jojo082708/fsr_recorder_v7/docs/設計說明.md

# 外穿式布鞋 FSR 雙點足底力量量測平台：AFO v17 設計說明（版次 B，草案，待確認）

## 0. 這版改了什麼（相對於 v16 草案）

| 你的要求 | v17 的做法 |
|---|---|
| 保留小腿件（上面放麵包板，已經列印） | `AFO_leg` 完全沿用 v15 原件，沒有任何修改。腳底件後跟杯的內側介面也保持不變（小腿件套筒和後跟杯之間的間隙約 0.4 mm） |
| 刪除外掛電控盒（E 模組盒、滑軌、托盤） | 已刪除。麵包板和 ESP32 改放在小腿件背面原本的位置，圖上只是示意 |
| 腳底板不要做成腳的形狀，要像 AFO（參考圖 3） | 回到 v15 的 AFO 托盤外形（圓角鞋底輪廓），有立邊、後跟杯和兩側束帶扣環。腳印只用來定感測器位置 |
| 只在大拇趾球和腳跟放滾珠式 FSR | 托盤底板上挖兩個感測匣口袋：S1（第一蹠骨頭）、S2（腳跟）。匣子頂面和底板面（z = 15）齊平 |
| 刪除舊 FSR 構造 | 刪除 v15 的舊 FSR 構造，填平到 z = 15：<br>• x≈100 的橫向貫穿槽，以及它穿過兩側牆的開口（已補牆）<br>• 中央 T 形溝<br>• 兩條長方形凹槽 |

| 只考慮鞋子數據（鞋底長 31 cm、寬 11 cm） | 托盤自 x = 80 往前拉長 ×1.286、加寬 ×1.133（平滑過渡），腳底件變成 346 × 134 × 76。後跟杯（x < 80，小腿件介面）完全不動。鞋頭擋塊、束帶扣環隨托盤一起放大 |

束帶扣環、底部三角格柵都照 v15 保留。

工程圖：`drawings/FSR_AFO_v17_Drawings.pdf`（12 張，A3）。3D 成品檢視：https://claude.ai/artifact/WfMZFsg2Vjy7nbR9LSAPM5（原始碼 `viewer/index.html`，模型由 `cad/export_glb.py` 產生）。

| 圖號 | 內容 |
|---|---|
| FSR-01 | 整體側視圖 |
| FSR-02 | 整體正視圖 |
| FSR-03 | 整體後視圖 |
| FSR-04 | 整體俯視圖 |
| FSR-05 | 腳底件底視圖 |
| FSR-06 | 整體等角圖 |
| FSR-07 | 布鞋 + 平台組合等角圖 |
| FSR-08 | 固定機構爆炸圖 |
| FSR-09 | 雙 FSR 剖面圖 |
| FSR-10 | 電子模組與走線圖 |
| FSR-11 | 整體爆炸圖 + 零件表 |
| FSR-12 | 感測器位置圖 |

座標系沿用 v15：原點在腳底件後緣底面的中線上，+X 朝腳尖、+Y 朝左（左腳時是外側）、+Z 朝上，單位 mm。

---

## 模組化（可拆卸）

- 共用後段 F1A：後跟杯、小腿件介面、S2 感測匣、走線出口、H1 墊塊插腳孔。只印一次。
- 可換前段 F1B：S1 感測匣，依尺寸產生，搭配對應的鞋頭擋塊 T1。
- 接合方式：x = 120 底板搭接 30 mm，6 × M4×12 平頭螺絲由底面鎖入後段熱熔螺母，可重複拆裝。
- 放大範圍：從 x = 140 之後才開始放大，所以後段在所有尺寸都相同。
- 赤腳：插入 H1 腳跟墊塊（12 mm 月牙形，2 支 Ø5 插腳），腳跟位置與穿鞋相同，感測器位置不變。
- 產生任意尺寸：`python3 cad/export_kit.py OUT shoe:長x寬 barefoot:腳長x腳寬`。

## 兩個版本（AFO_VARIANT）

| 項目 | 赤腳版 barefoot | 穿鞋版 shoe |
|---|---|---|
| 依據 | 腳掌 254 × 100（量測） | 鞋底 310 × 110（量測） |
| 腳底件 | 共用後段 + 赤腳前段 → 299 × 122 × 76 | 共用後段 + 穿鞋前段 → 349 × 134 × 76 |
| 腳跟定位 | H1 腳跟墊塊 12 mm | 鞋跟（腳跟→鞋底 12，待確認） |
| S1 / S2 | (197.3, −25) / (45.3, +12) | (197.3, −25) / (45.3, +12) |
| 鞋頭擋塊 | 客製：內緣沿腳趾包絡 + 3 mm，厚 12、高 22，2 支 Ø6 插腳（舊插槽填平） | v15 造型放大 |

## 1. 尺寸參數表（⚠ = 待確認）

| 參數 | 目前值 | 狀態 | 說明 |
|---|---|---|---|
| Shoe_Length | 310 | 已量測 | 鞋尖位置 = 8.3 + 310 + 間隙 2 = 擋塊內面 |
| Shoe_Max_Width | 110 | 已量測 | 托盤前掌內寬 = 110 + 2 × 2。**鞋跟寬必須 ≤ 66**（小腿件套筒內寬）⚠ |
| Sole_Thickness | 25（示意） | ⚠ | 只影響束帶長度和組合圖 |
| **Heel_Offset** | 12 | ⚠ | 腳跟後緣到鞋底後緣的距離。影響 S1、S2 的 X 座標 |
| Platform_Thickness | 15 | 沿用 v15 | 底板面 z = 15，感測匣頂面在這個高度，TPU 傳力柱再高出 0.3 |
| **Sensor1_Position** S1 | (197.3, −25) | ⚠ | X = 8.3 + Heel_Offset + 177，Y = 47 − 72 |
| **Sensor2_Position** S2 | (45.3, +12) | ⚠ | X = 8.3 + Heel_Offset + 25（圖上標 21），Y = 47 − 35 |
| 感測器位置 | 固定 | 設計值 | 不可移動（已取消滑動/偏心調整）；換人時改 Foot_S1 / Foot_S2 參數重印 F1 |
| Ring_Raise | 3 | 設計值 | 感測匣 Ø42 外圈凸環高出底板 3 mm（1.2 倒角）；TPU 傳力面再高 0.3 |
| **ESP32_Size** | 51.5 × 28.3 × 13 | ⚠ | 放在小腿件背面 |
| **Breadboard_Size** | 165 × 55 × 9.5 | ⚠ | 放在小腿件背面（你已經列印的位置） |
| Stop_Gap | 1.0 | 校正後調整 | 決定 FSR 最大受力，約 69 N |
| FSR 402 | Ø18.3、感測區 Ø12.7、厚 0.45 | ⚠ 規格書 | |

所有參數都在 `cad/afo_v17.py` 開頭的 `P`。

---

## 2. 模組說明

### F1 AFO 腳底件 v17（由 v15 修改）

- 外形、後跟杯、束帶扣環、鞋頭擋塊插槽、底部格柵都沿用 v15。
- 兩個感測器正下方 Ø46 範圍改成實心（z 0 → 15），受力可以直接經底板傳到地面。
- 感測器口袋：Ø32 孔（z 3 → 15），加 Ø42.4 × 4 沉台，以及 3 個 M2.5 熱熔螺母孔（Ø3.6）。
- 走線槽：寬 6、z 10 → 13.5，上面蓋 B2 走線蓋板（1.5 t，和底板齊平）。
  - 路線是 S1 → 往後跟 → 與 S2 的線會合 → 後跟杯背面的 Ø5 出線孔（z ≈ 11.75）。
  - 這段會從小腿件套筒底下通過，所以電線不會外露在鞋底摩擦面上。

### L1 小腿件 v15（不改）

- 下緣套筒插進後跟杯內側，用兩側螺絲固定。
- 套筒的內面同時是鞋跟的定位面。
- 背面放麵包板和 ESP32。

### T1 鞋頭擋塊（v15，9 種擇一）

- 依鞋長選 T6 / T9 / T12，依鞋頭高度選 H16 / H22 / H28。

### A4 魔鬼氈（38 mm × 2）

- 穿過托盤兩側的 v15 扣環（x ≈ 140、x ≈ 188），跨過鞋面。
- 小腿部分沿用 v15 的小腿束帶。

### C 鋼珠式 FSR 感測匣 × 2（剖面見 FSR-09）

整個感測匣鬆開 3 支 M2.5 就能從上方取出。

| 件號 | 說明 |
|---|---|
| C0 感測匣殼 | PETG。Ø42 凸環（高出底板 3）+ Ø27 導筒。內有 Ø12 止擋肩和 Ø21.4 頂唇；3 個 M2.5 沉頭孔（固定位置） |
| C1 TPU 導槽 | TPU 95A，外徑 Ø22，頂面 Ø21。有 Ø5.15 導槽孔，下緣是 Ø4.5 防脫唇 |
| C2 鋼珠 | Ø5，SUJ2 |
| C3 FSR 402 | 尾線朝走線槽方向引出 |
| C4 FSR 支撐座 | Ø22 × 1.5，PETG 100% 填充，或用鋁片 |
| C5 保護傳力片 | Ø10 × 0.5，SUS304，用轉印膠黏在 FSR 正中央 |

**鋼珠限位**：
- 側向：被導槽孔限制，只能上下移動。
- 往下：有防脫唇擋住。
- 整個導槽又被頂唇和止擋肩鎖在殼內，所以鋼珠不會脫出。

**受力路徑**：鞋底 → TPU 頂面 → 鋼珠 → 保護片 → FSR 中央 → 支撐座 → 腳底件底板 → 地面。

**過載保護**：
- TPU 被壓下的深度超過 Stop_Gap = 1.0 mm 時，外環會坐上止擋肩，多出來的力繞過 FSR。
- FSR 最大受力 ≈ 68.7 · δ^1.5 ≈ 69 N（以 TPU 95A 概算，必須校正）。

**注意**：腳跟的感測匣在小腿件套筒內側（嵌板外緣 y = 33.0，套筒內面 y = 33.2）。

### E 電子（小腿件背面，零件不改）

- 接線：每顆 FSR 串一顆 10 kΩ 接到 3.3 V，分壓點接 ESP32 ADC1（例如 GPIO34 / GPIO35）。
- FSR 線經 2 × JST-XH 2P 接到麵包板。
- 電源方式待確認（行動電源或 18650 模組）。

---

## 3. 零件尺寸表

| 件號 | 名稱 | L × W × H | 數量 | 材料 / 製程 |
|---|---|---|---|---|
| F1A | 腳底件後段 | 139 × 125 × 76 | 1 | PETG 列印 |
| F1B | 腳底件前段 | 237 × 134 × 39 | 1 | PETG 列印 |
| L1 | AFO 小腿件 v15 | 69 × 98 × 239 | 1 | 已列印，不改 |
| T1 | 鞋頭擋塊（v15 造型放大） | 55 × 106 × 30 | 1 | PETG |
| B2 | 走線蓋板 | 172 × 36 × 1.5 | 1 | PETG |
| C0 | 感測匣殼（凸環） | Ø42 × 14.8 | 2 | PETG 100% |
| C1 | TPU 導槽 | Ø22 × 11.8 | 2 | TPU 95A |
| C2 | 鋼珠 | Ø5 | 2（+ 備品 4） | SUJ2 |
| C3 | FSR 402 | Ø18.3 × 0.45 | 2（+ 備品 2） | Interlink |
| C4 | FSR 支撐座 | Ø22 × 1.5 | 2 | PETG / 鋁 |
| C5 | 保護傳力片 | Ø10 × 0.5 | 2 | SUS304 |

## 4. BOM

| 項目 | 規格 | 數量 |
|---|---|---|
| FSR 402 | Interlink | 2 + 2 備品 |
| 鋼珠 | Ø5，G10 | 2 + 4 備品 |
| 保護片 | Ø10 × 0.5 SUS304 | 2 + 2 備品 |
| 轉印膠 | 3M 467MP | 少量 |
| ESP32 DevKit / 長條麵包板 | （⚠ 型號待確認） | 各 1 |
| 電阻 | 10 kΩ 1% | 2 |
| JST-XH 2P 線組 | AWG26–28 矽膠線，約 40 cm | 2 |
| 熱熔螺母 M2.5 | Ø3.6 × 4 | 6 |
| M2.5 × 6 沉頭螺絲 | | 6 |
| 魔鬼氈 | 38 mm，公母各 1 m | 2 條 |
| 螺旋套管 + 束線扣 | | 1 組 |
| 止滑橡膠片（底面）/ 止滑矽膠片（底板面，感測匣處開 Ø22 孔） | 2 mm / 1 mm | 各約 300 × 120 |
| 耗材 | PETG 約 520 g；TPU 95A 約 10 g | |

## 5. 組裝流程

1. **熱熔螺母**：在 F1 兩個口袋的沉台壓入 3 × M2.5 熱熔螺母。
2. **感測匣**（每組）：
   1. 把保護片黏在 FSR 正中央。
   2. FSR 放上支撐座，尾線對準殼體開口。
   3. 鋼珠壓進 TPU 導槽，壓過防脫唇。
   4. 導槽從上方壓入殼體，通過頂唇。
   5. 支撐座卡進殼體底部。
3. **放入感測匣**：放進口袋，選好偏心角度，鎖 3 × M2.5。FSR 尾線接上延長線，放進走線槽。
4. **走線**：延長線從後跟出線孔拉出，蓋上 B2 蓋板（用 2 點膠或過盈卡入）。
5. **小腿件**：裝回 L1（v15 原本的螺絲）。電線沿後跟杯背面往上，套上螺旋套管，用束線扣固定，接到麵包板。
6. **穿鞋**：選好鞋頭擋塊並插上，放入布鞋，扣上魔鬼氈和小腿束帶。

## 6. 測試流程

1. 零點檢查。
2. 單點靜態加載：0 到 40 kg 分階，加載、卸載各 3 次。
3. 隔著鞋底校正。
4. 全身體重靜態測試：雙腳站、單腳站、前傾、後傾。
5. 慢走約 100 步，確認重現性，並檢查潛變和螺絲鬆動。
6. 最後才接到外骨骼做步態量測。

（詳細步驟同 v16 版說明，見 git 歷史。）

## 7. 3D 列印建議

| 零件 | 材料 | 層高 | 外殼 / 填充 | 方向 |
|---|---|---|---|---|
| F1 腳底件 | PETG | 0.2 | 4 牆，30% gyroid | 底面朝下（同 v15） |
| C0 感測匣殼 | PETG | 0.12 | 100% | 嵌板朝下 |
| C1 TPU 導槽 | TPU 95A | 0.12 | 100%，約 20 mm/s | 頂面朝下 |
| B2 蓋板 / C4 支撐座 | PETG | 0.1 | 100% | 平放 |

- 腳底件分兩件列印（印表機 300 × 300 × 350）：F1A 後段 139 × 125 × 76、F1B 前段 237 × 134 × 39；x = 120 底板搭接 30 mm，6 × M4×12 平頭螺絲由底面鎖入後段 M4 熱熔螺母（見 FSR-15）。
- Ø22.4 / Ø22、Ø42.4 / Ø42 這些配合尺寸，建議先印公差試片確認。

## 8. 待你確認

1. 布鞋實測：鞋長、鞋寬、**鞋跟寬（必須 ≤ 66）**、Heel_Offset。
2. S2 距腳跟是 21 還是 25 mm。
3. 麵包板和 ESP32 在小腿件背面的實際位置與尺寸，以及電源方式。

輸出檔：`python3 cad/afo_v17.py --export out/`（STL / 3MF / STEP）、`python3 cad/export_glb.py out/AFO_v17_assembly.glb`；text-to-cad：`python textcad/afo_v17.py`。執行 `python3 cad/afo_v17.py --export out/`，會輸出所有 STL 和 `AFO_v17_foot_and_sensors.step`（faceted，與 v15 相同格式）。小腿件請直接沿用 v15 原檔。
