jojo082708/fsr_recorder_v7/drawings/16_兩版本比較_赤腳版_vs_穿鞋版.png

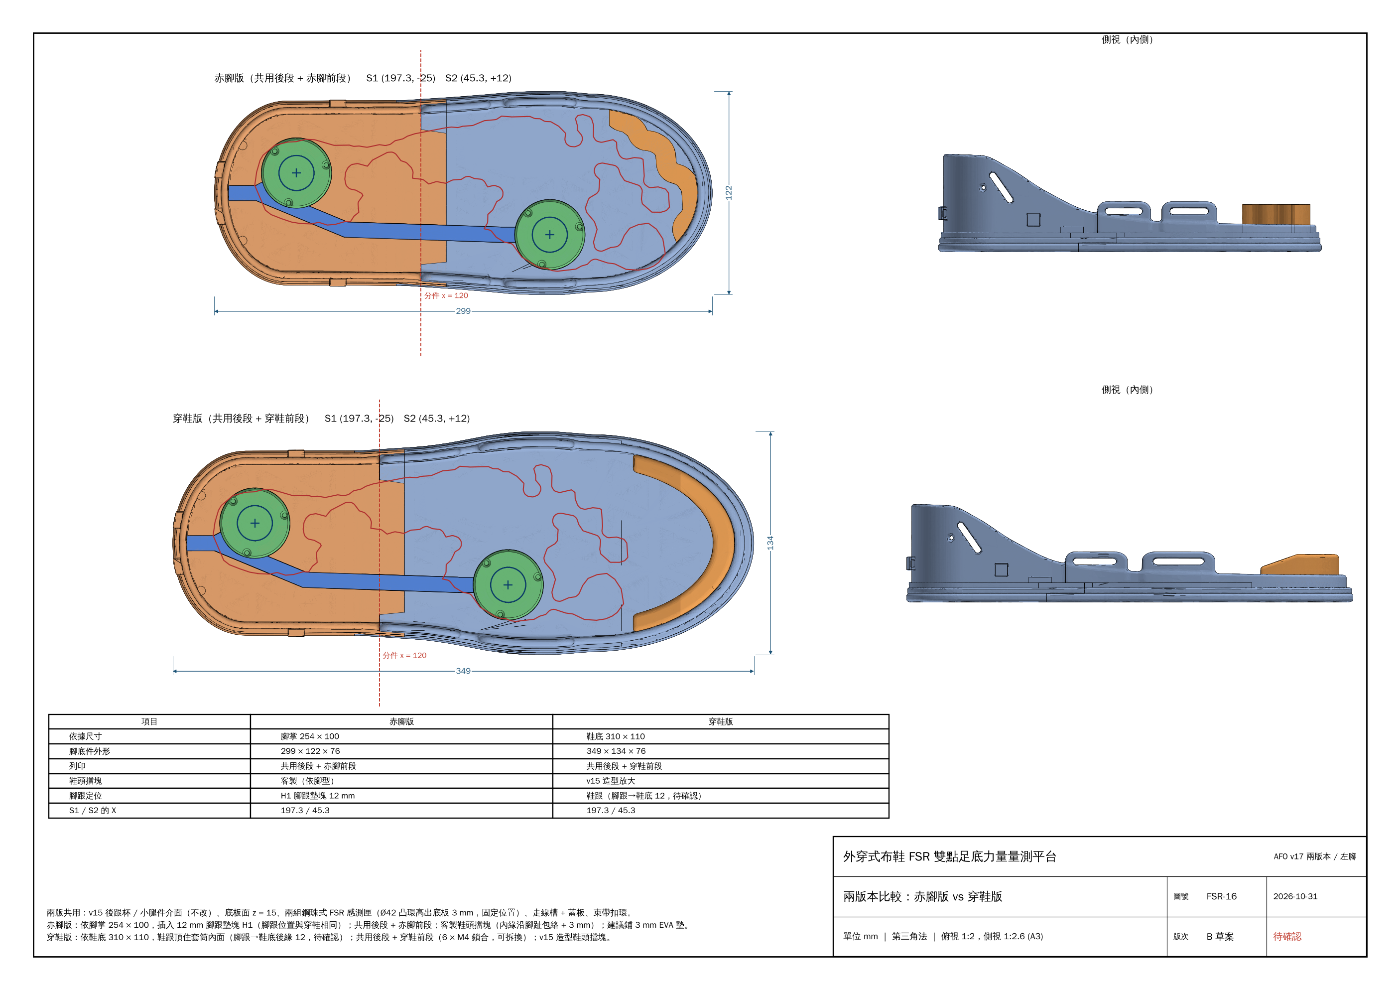
drawings/16_兩版本比較_赤腳版_vs_穿鞋版.png
