jojo082708/fsr_recorder_v7/drawings/17_模組化套件_共用後段_可換前段.png

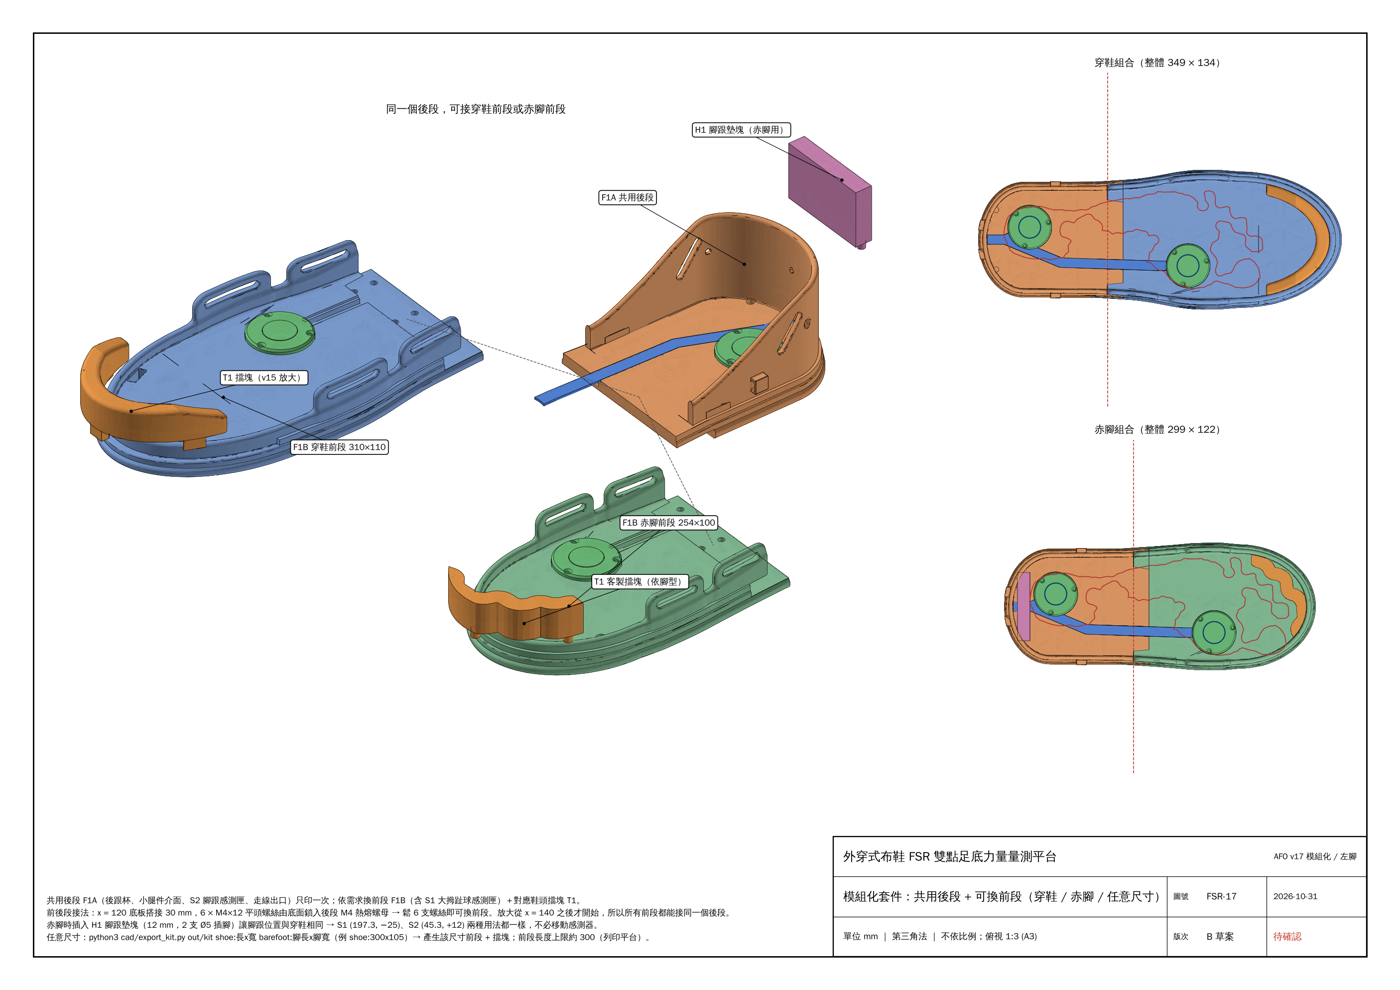
drawings/17_模組化套件_共用後段_可換前段.png
