jojo082708/fsr_recorder_v7/drawings/barefoot/01_側視圖.png

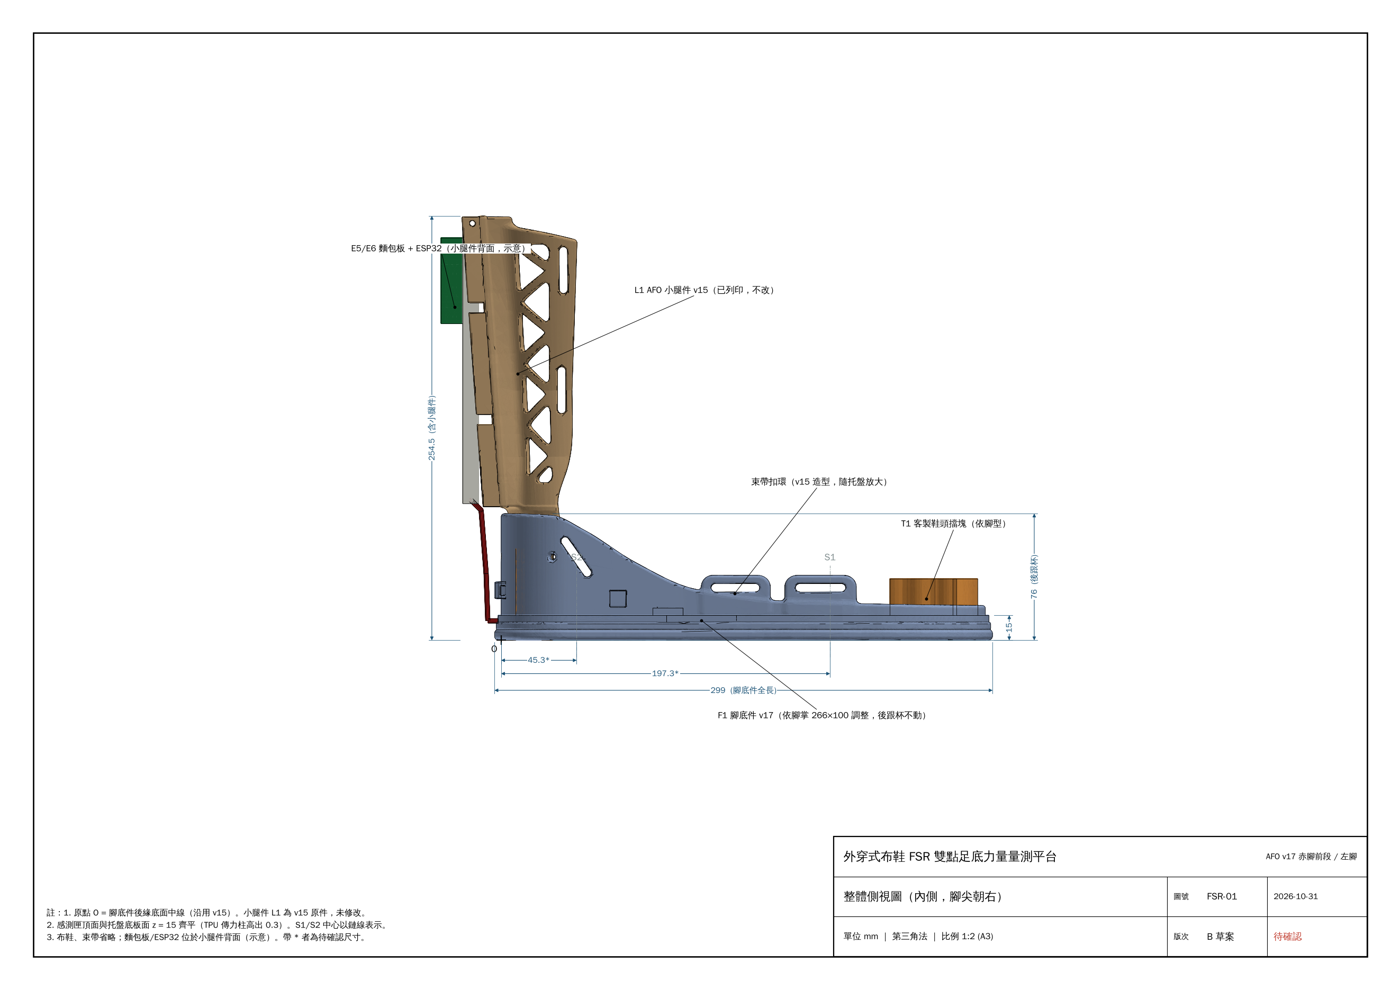
drawings/barefoot/01_側視圖.png
