jojo082708/fsr_recorder_v7/drawings/barefoot/02_正視圖.png

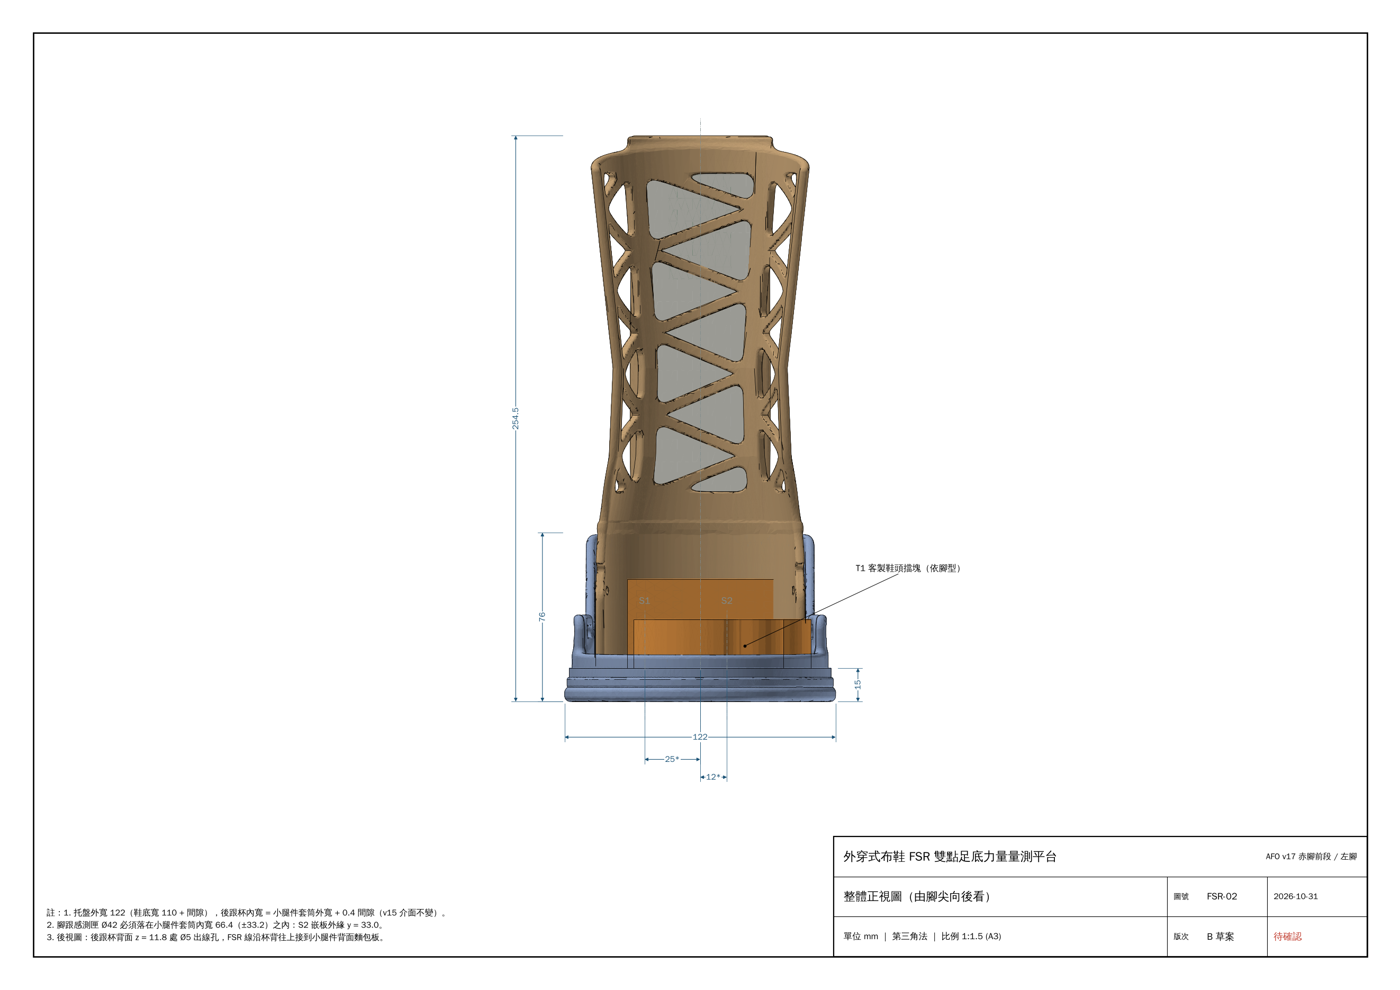
drawings/barefoot/02_正視圖.png
