jojo082708/fsr_recorder_v7/drawings/barefoot/04_俯視圖.png

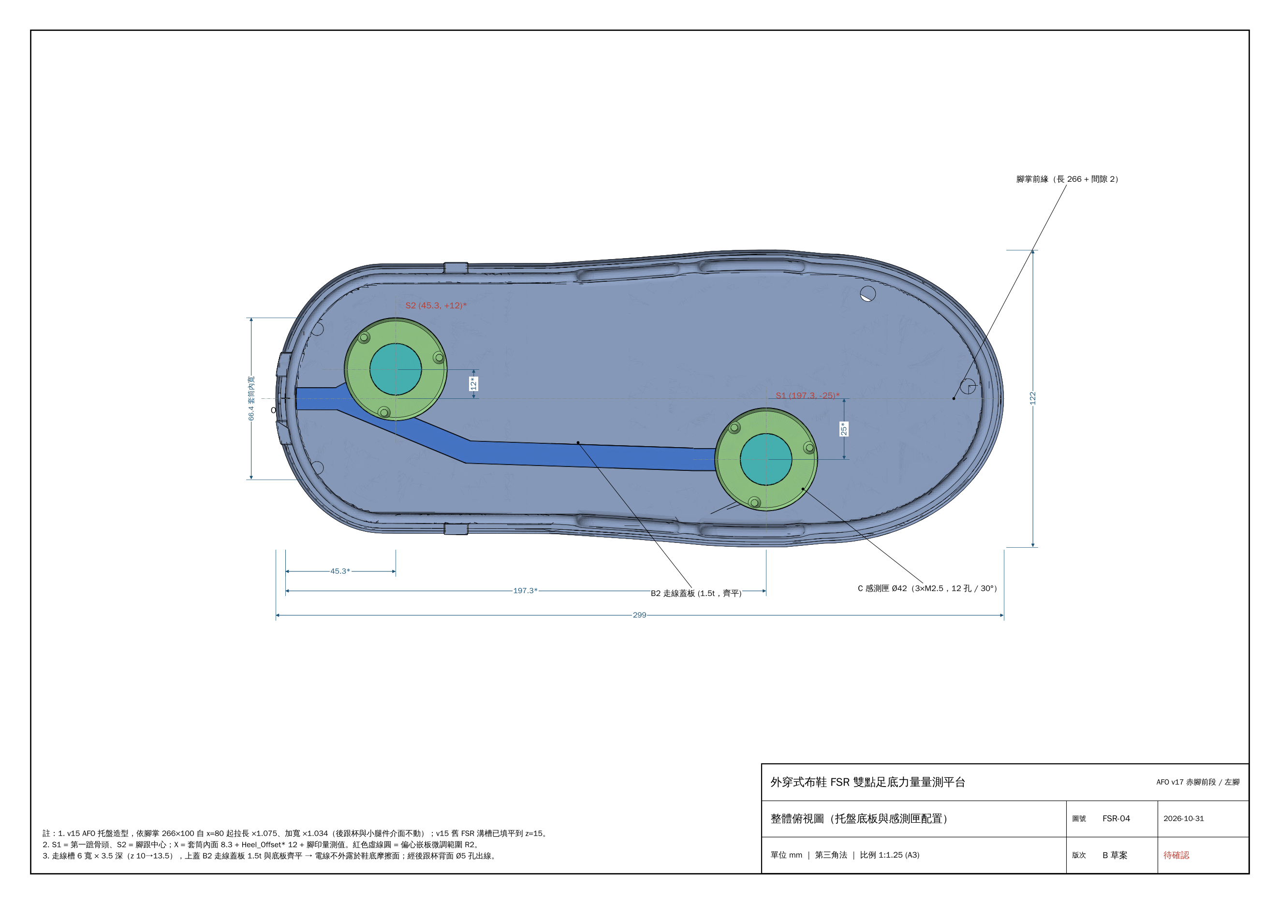
drawings/barefoot/04_俯視圖.png
