jojo082708/fsr_recorder_v7/drawings/barefoot/05_底視圖.png

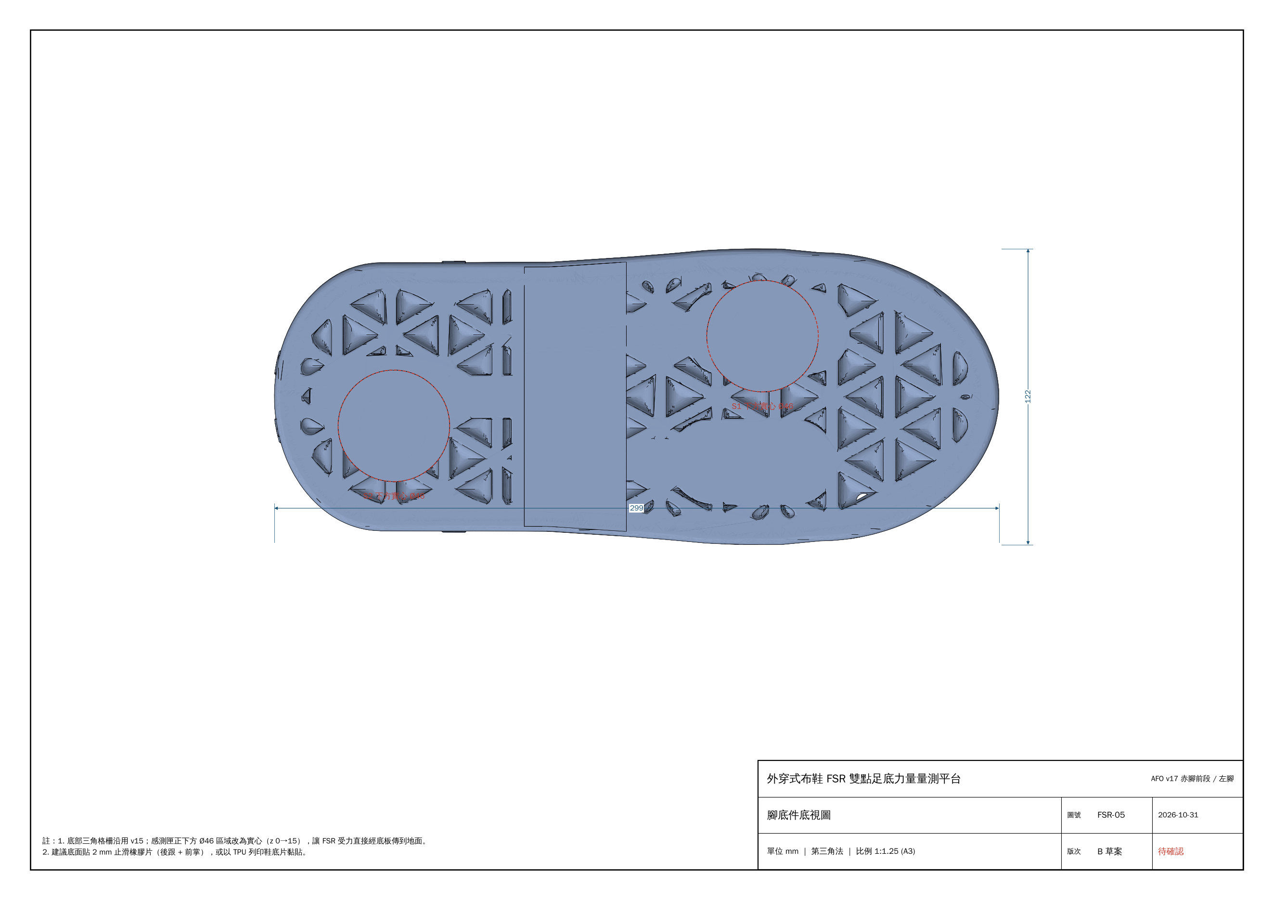
drawings/barefoot/05_底視圖.png
