jojo082708/fsr_recorder_v7/drawings/barefoot/06_等角圖.png

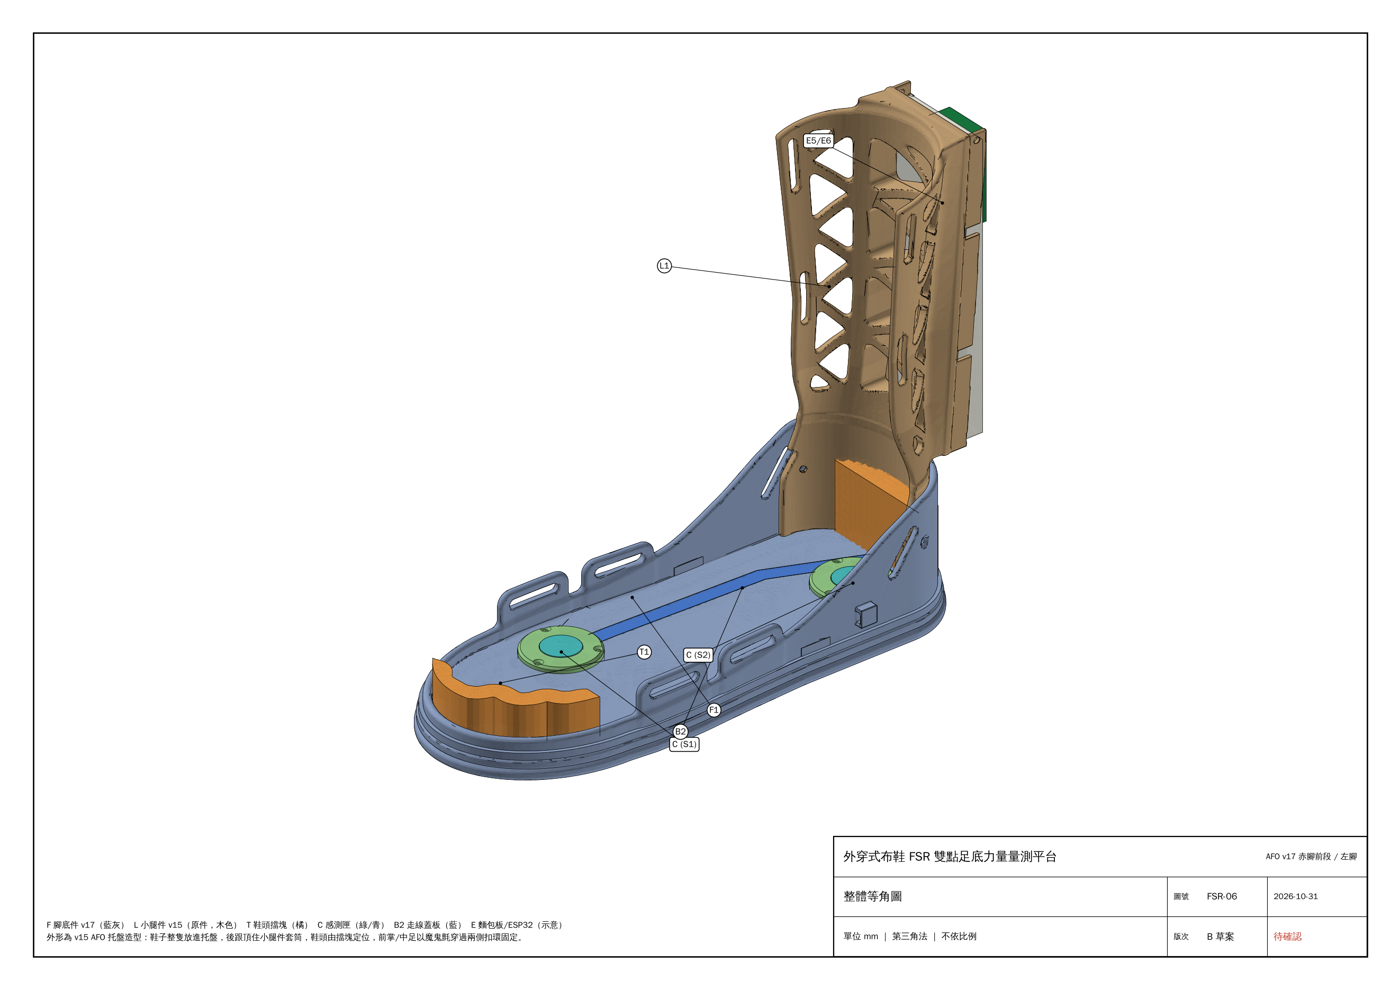
drawings/barefoot/06_等角圖.png
