jojo082708/fsr_recorder_v7/drawings/barefoot/07_布鞋平台組合等角圖.png

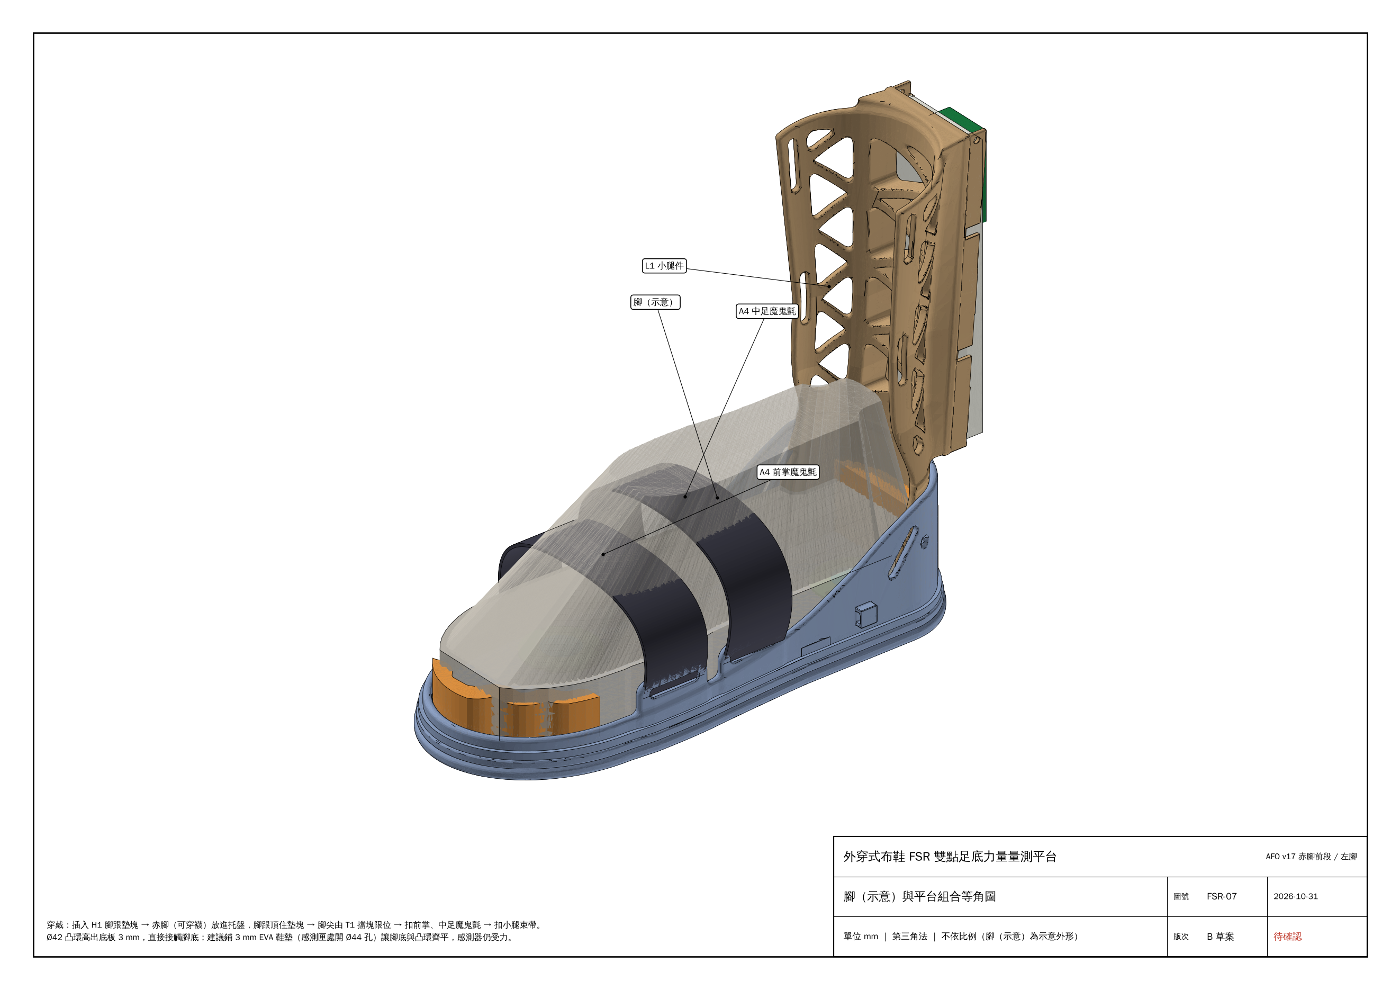
drawings/barefoot/07_布鞋平台組合等角圖.png
