jojo082708/fsr_recorder_v7/drawings/barefoot/08_固定機構爆炸圖.png

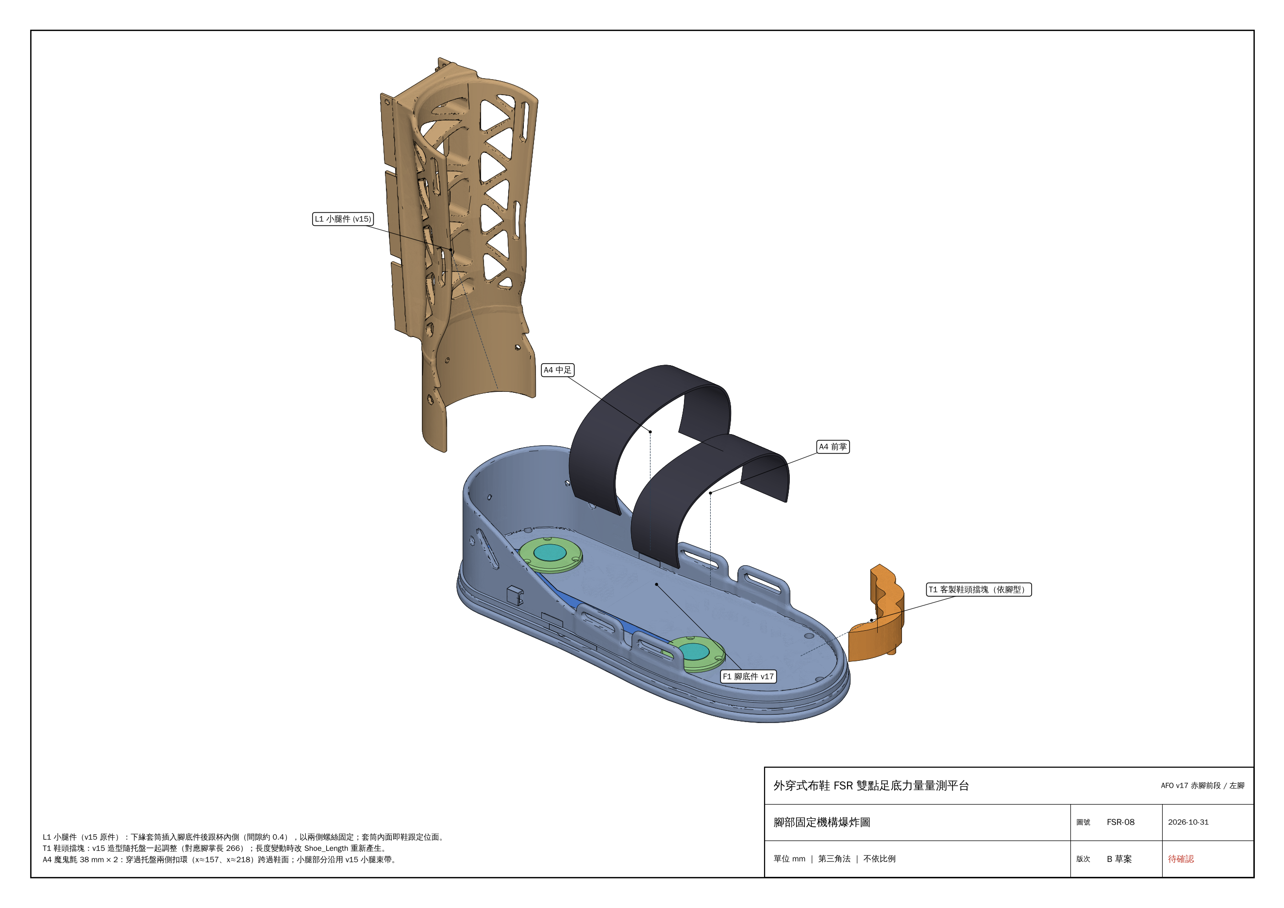
drawings/barefoot/08_固定機構爆炸圖.png
