jojo082708/fsr_recorder_v7/drawings/barefoot/09_雙FSR剖面圖.png

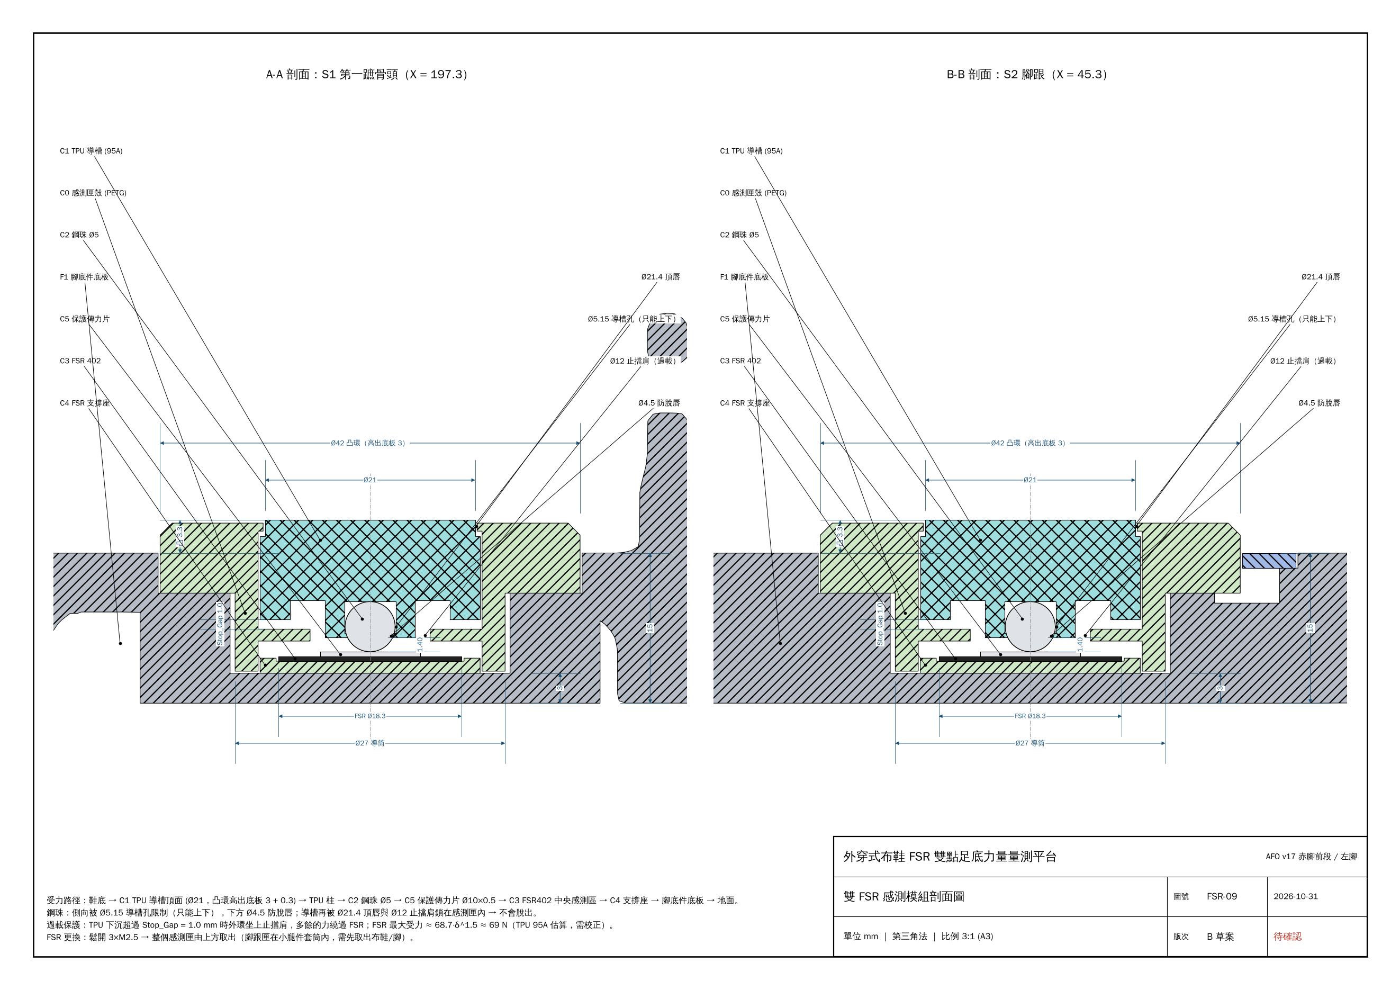
drawings/barefoot/09_雙FSR剖面圖.png
