jojo082708/fsr_recorder_v7/drawings/barefoot/11_整體爆炸組裝圖.png

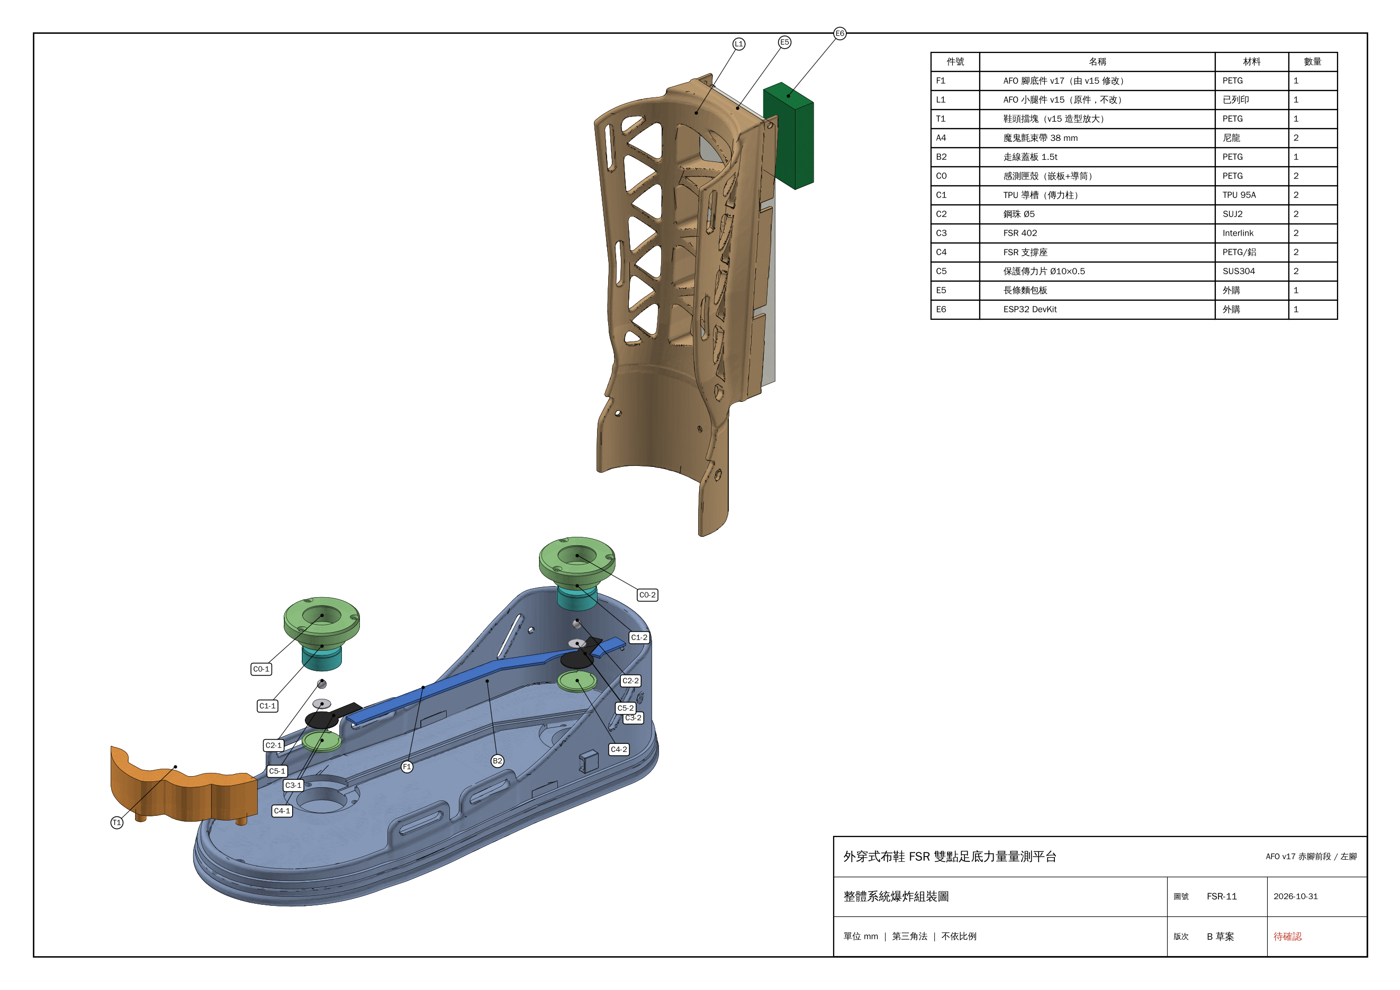
drawings/barefoot/11_整體爆炸組裝圖.png
