jojo082708/fsr_recorder_v7/drawings/barefoot/12_感測器安裝位置圖.png

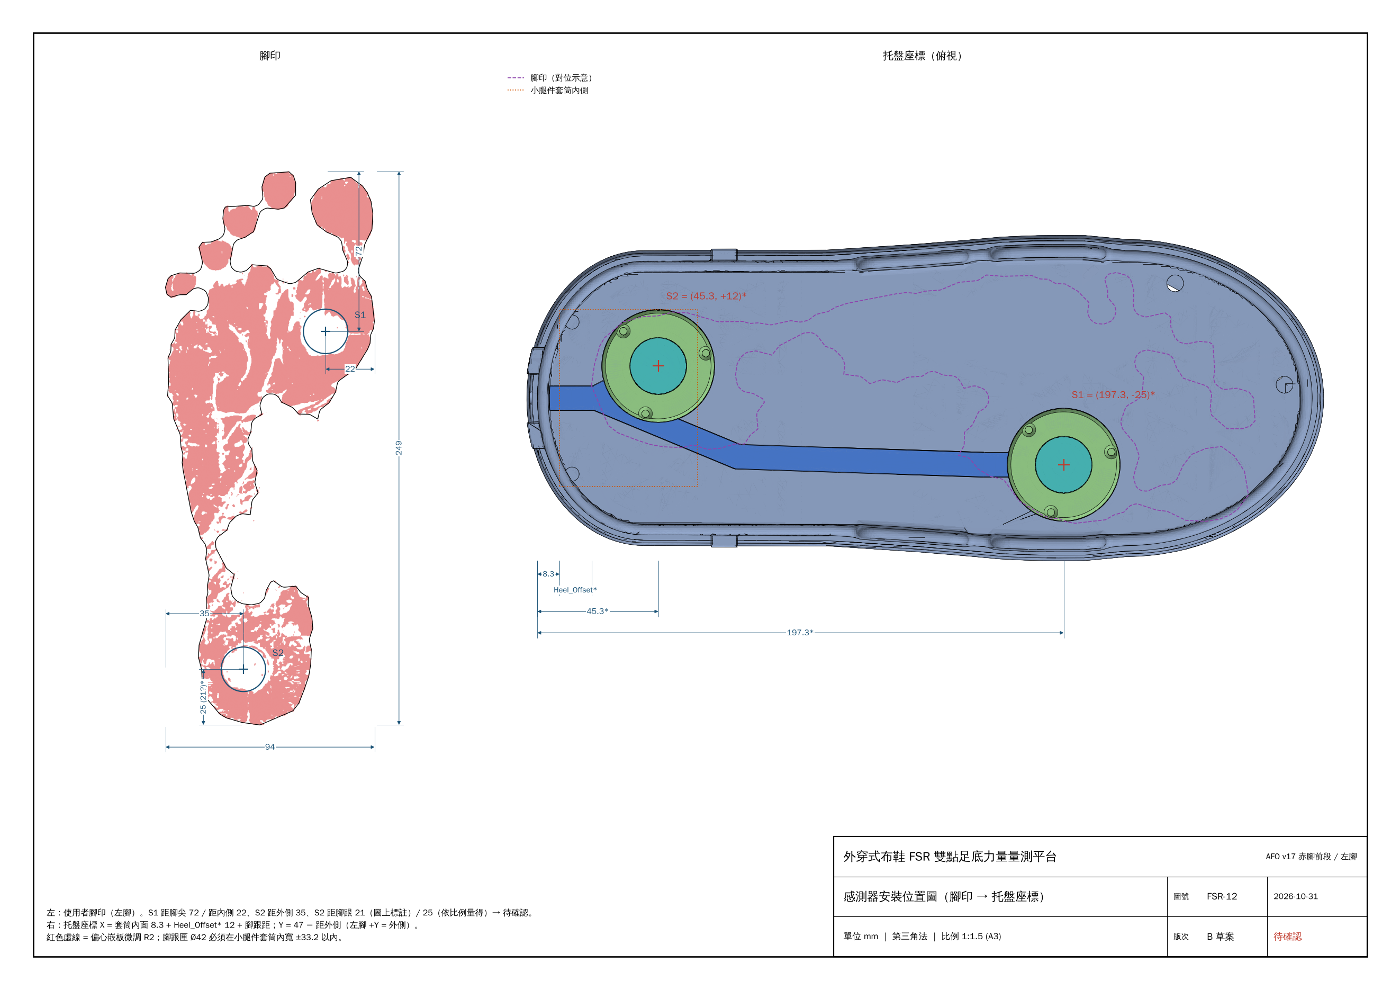
drawings/barefoot/12_感測器安裝位置圖.png
