jojo082708/fsr_recorder_v7/drawings/barefoot/13_腳印鞋型重合俯視圖.png

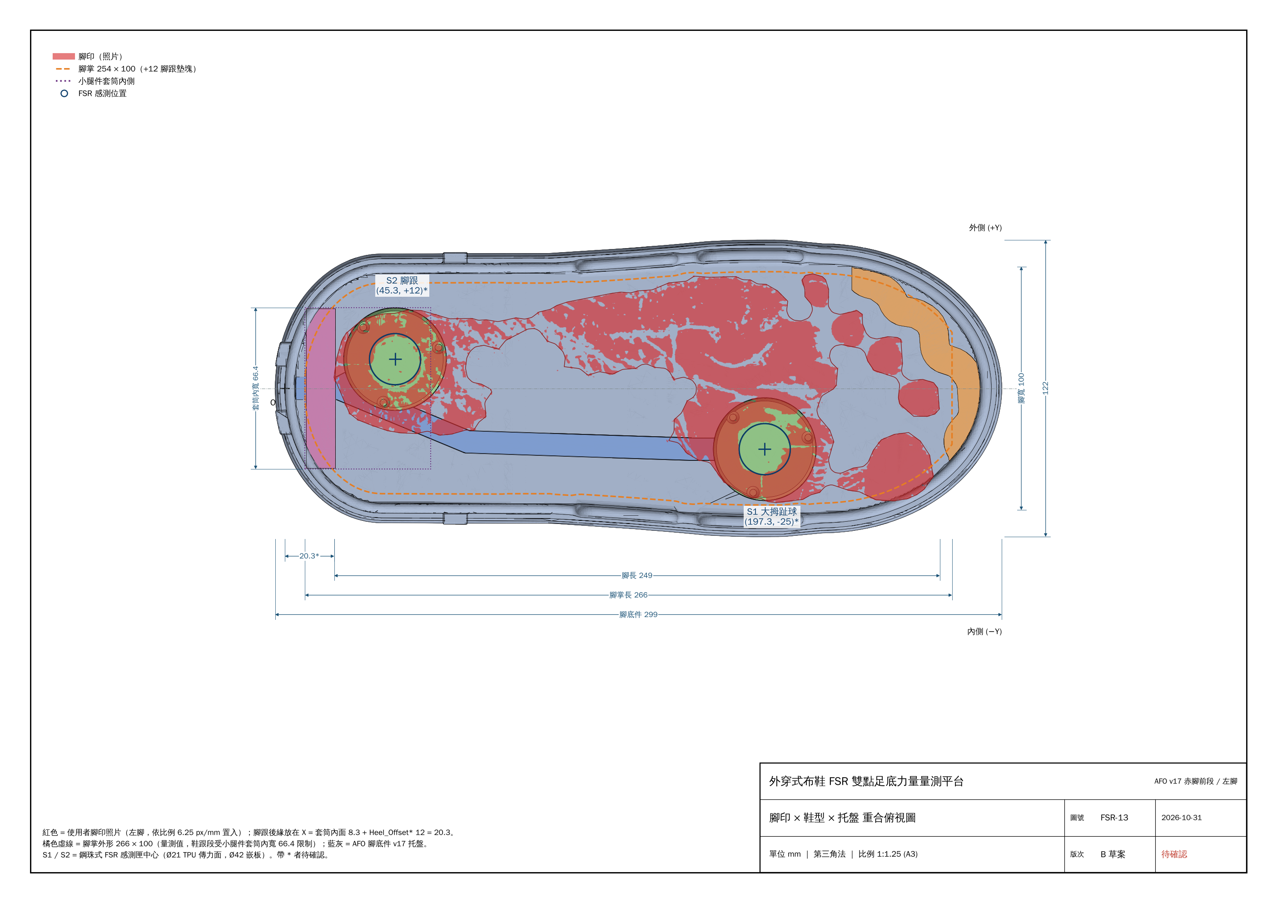
drawings/barefoot/13_腳印鞋型重合俯視圖.png
