jojo082708/fsr_recorder_v7/drawings/barefoot/14_修改前後對照.png

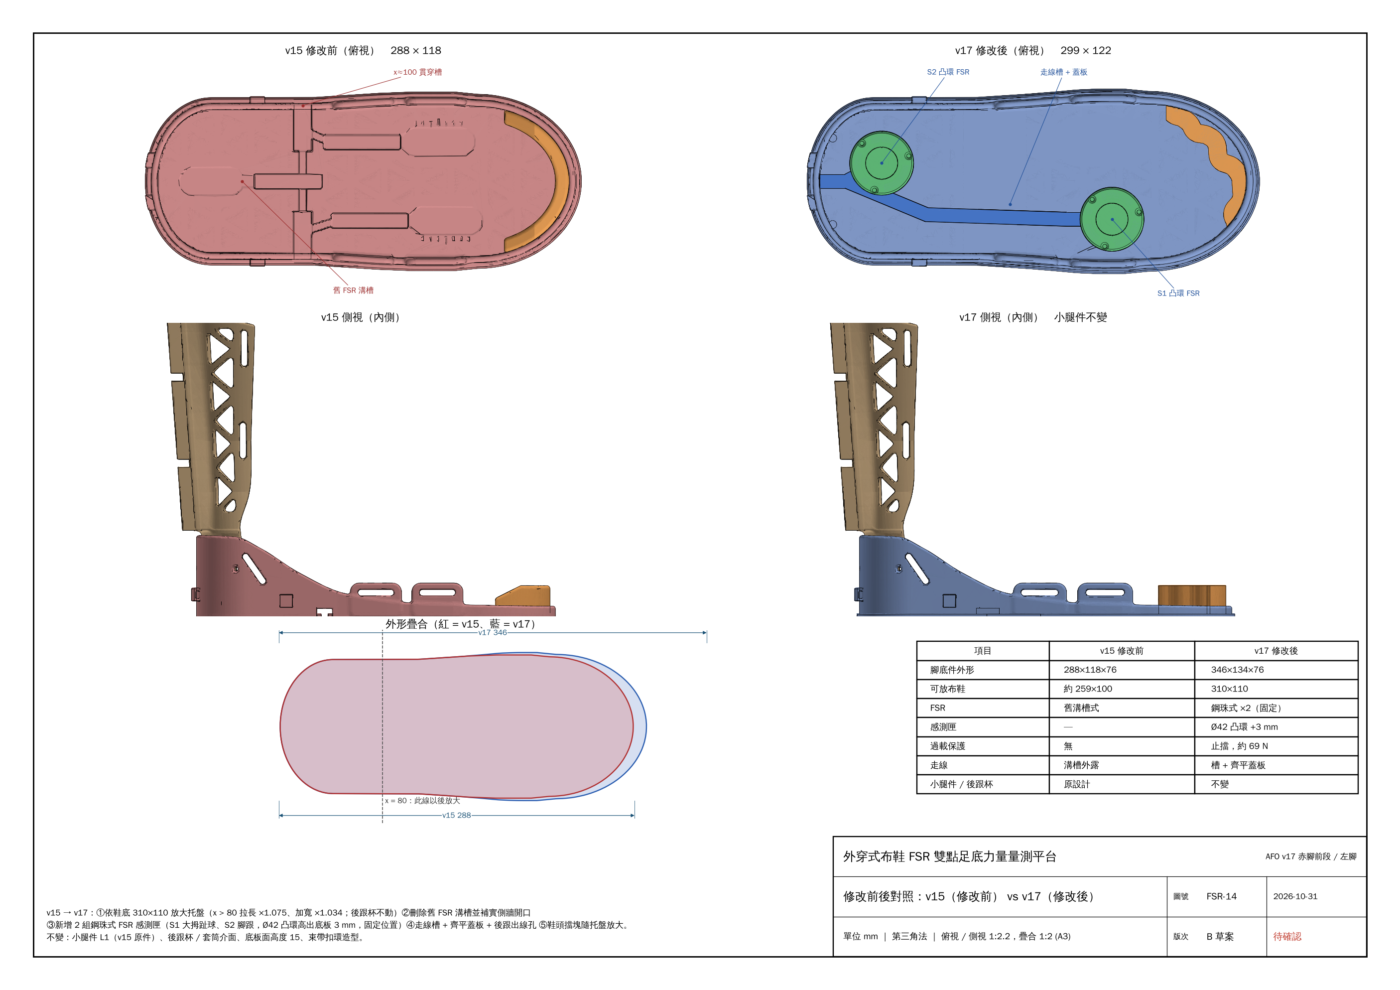
drawings/barefoot/14_修改前後對照.png
