jojo082708/fsr_recorder_v7/drawings/barefoot/15_分件與螺絲接合.png

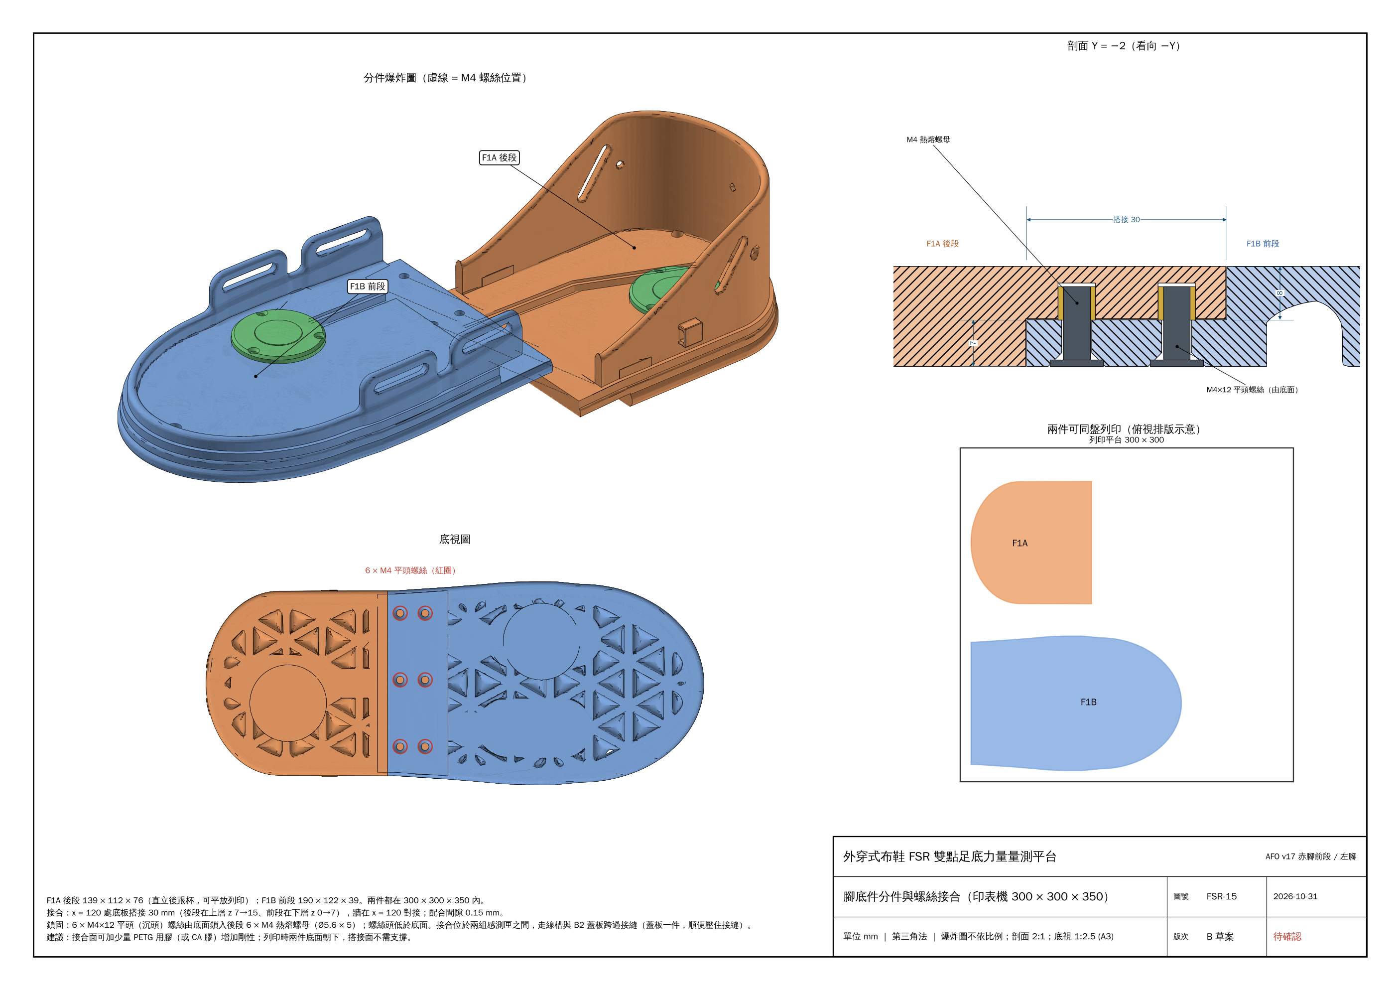
drawings/barefoot/15_分件與螺絲接合.png
