jojo082708/fsr_recorder_v7/drawings/shoe/04_俯視圖.png

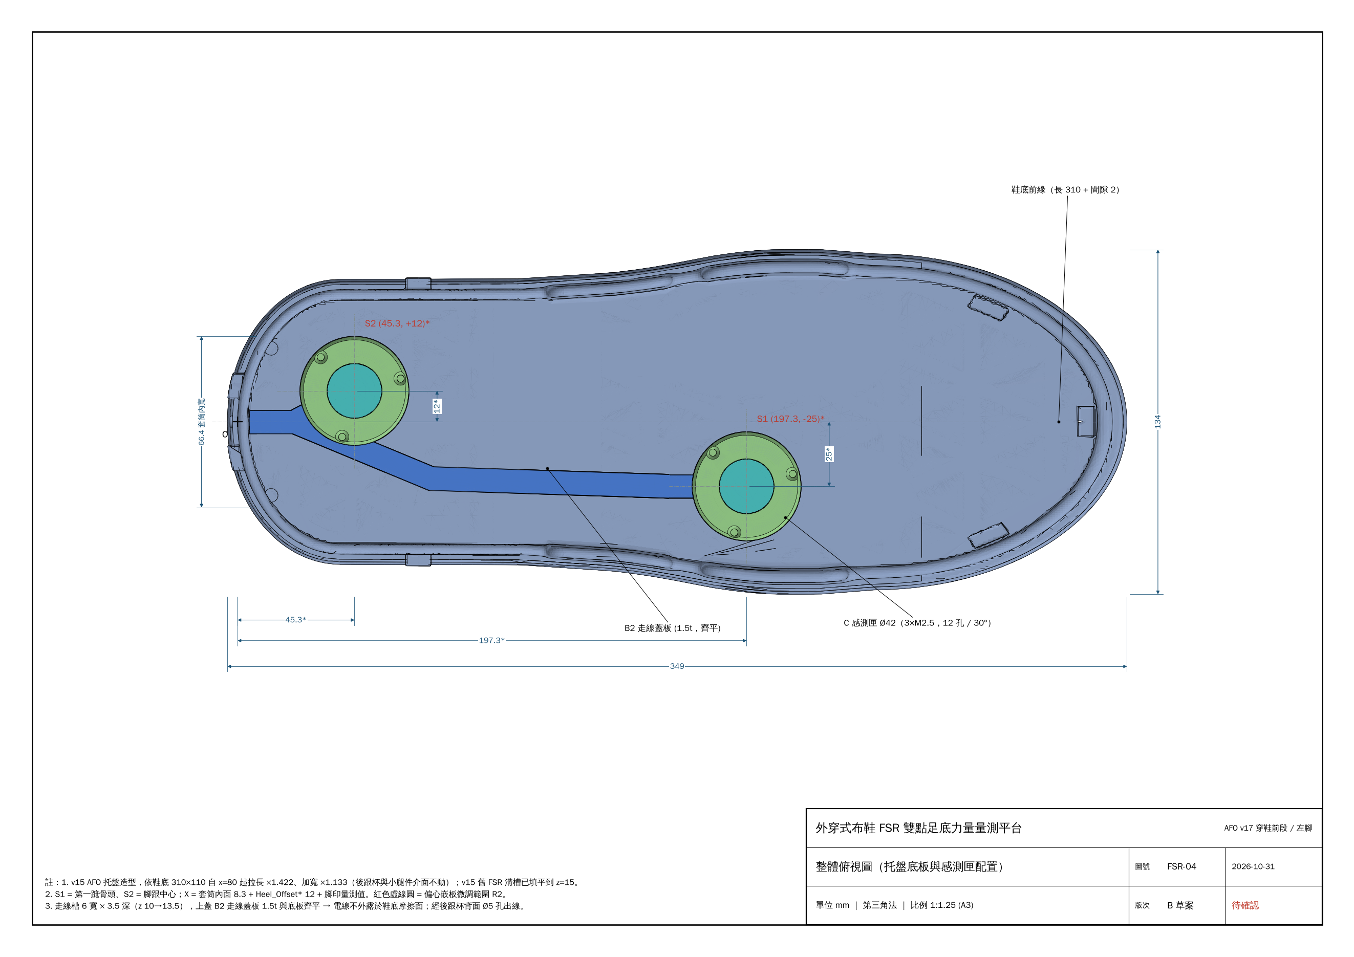
drawings/shoe/04_俯視圖.png
