jojo082708/fsr_recorder_v7/drawings/shoe/05_底視圖.png

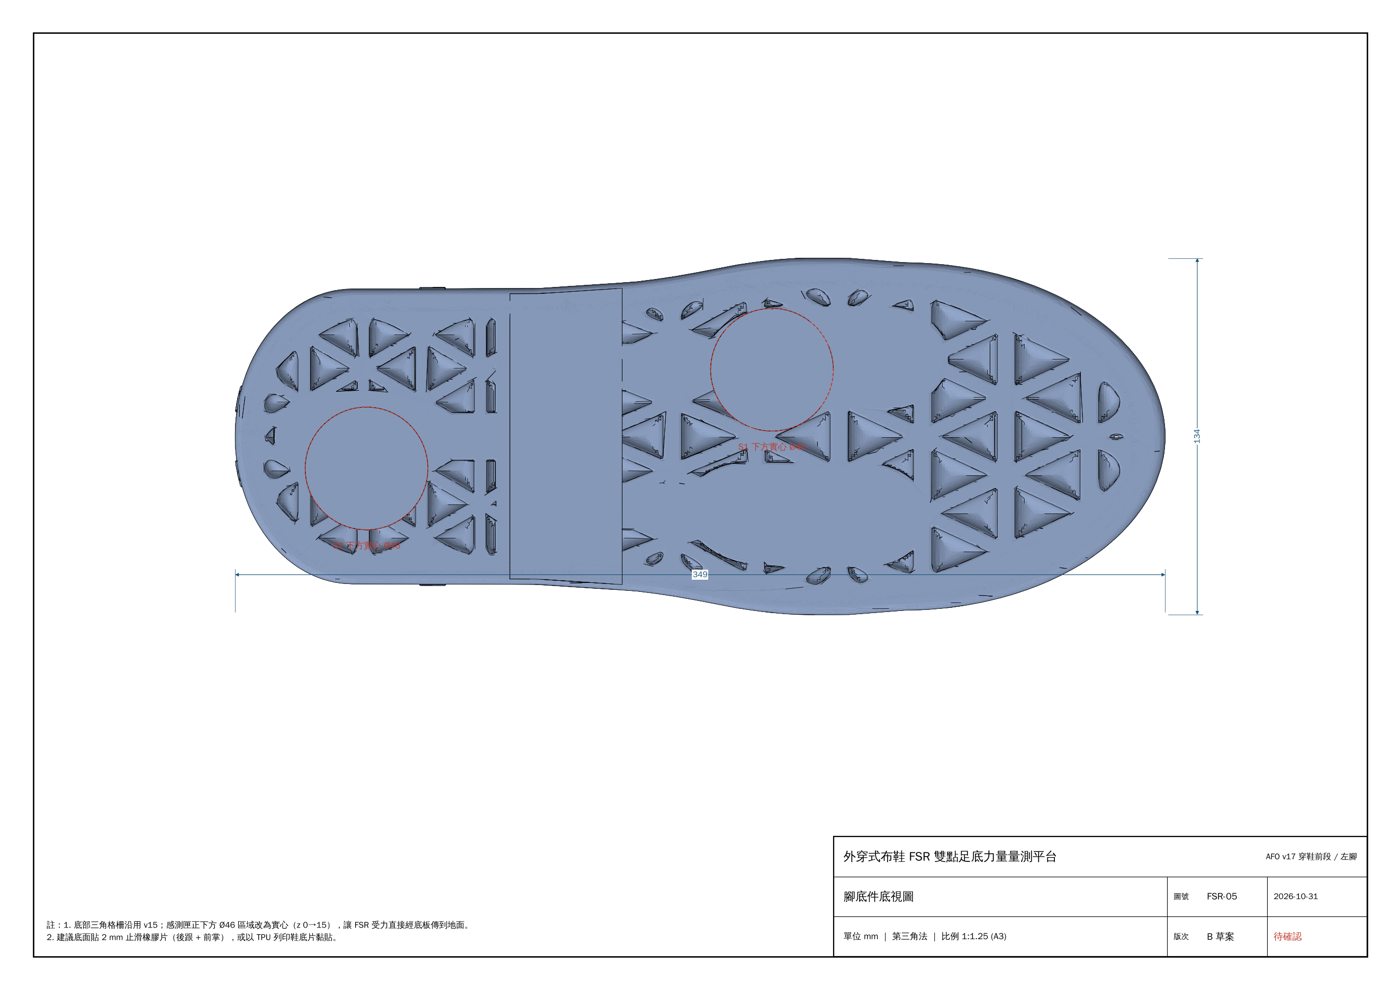
drawings/shoe/05_底視圖.png
