jojo082708/fsr_recorder_v7/drawings/shoe/10_電子模組與走線圖.png

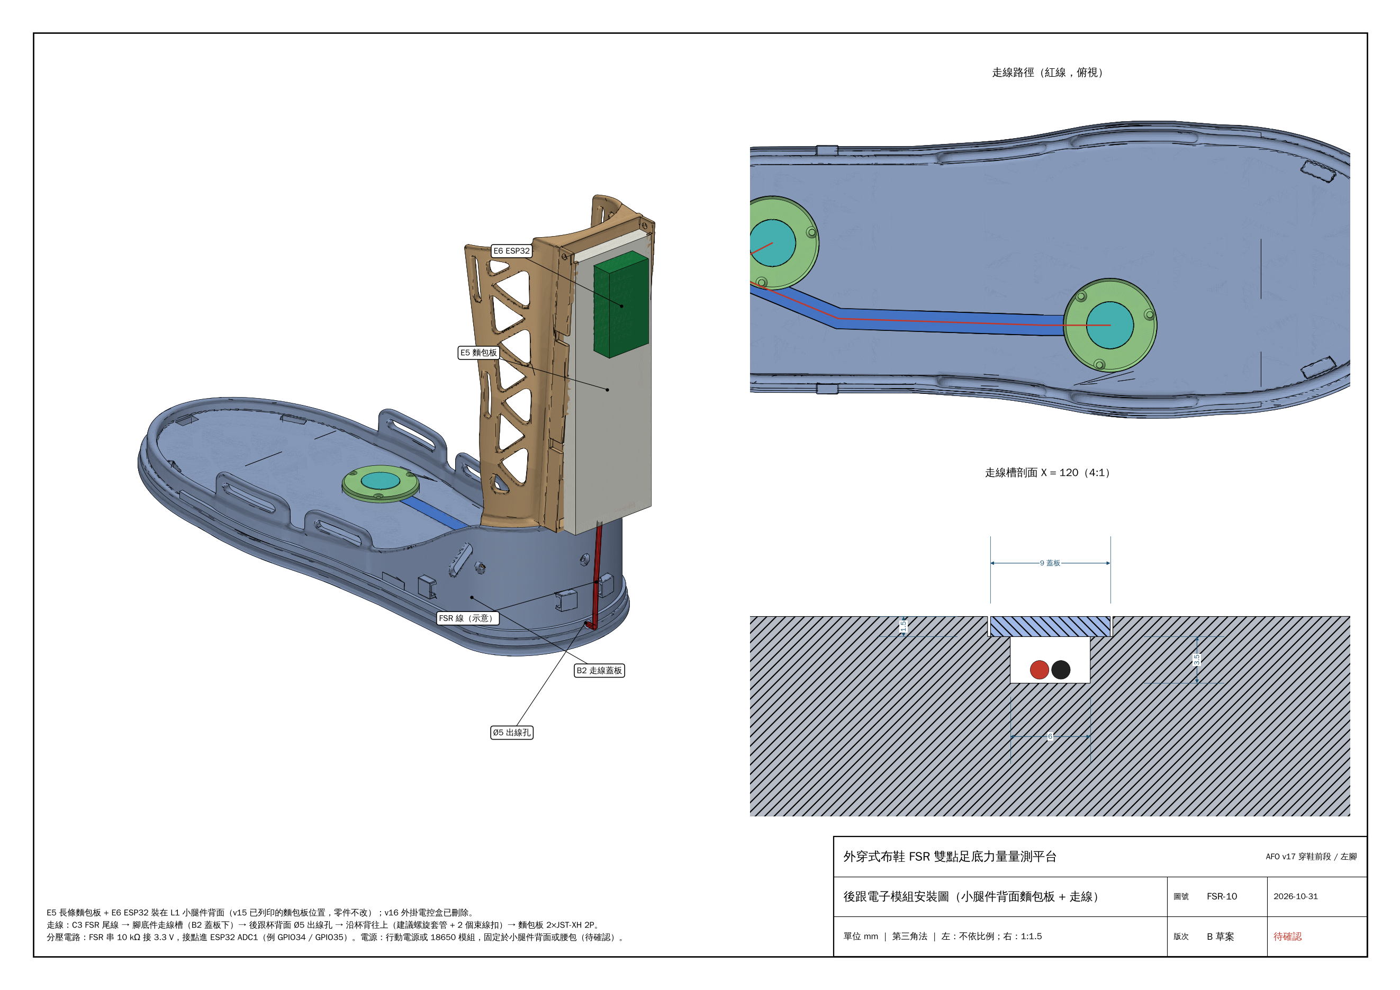
drawings/shoe/10_電子模組與走線圖.png
