jojo082708/fsr_recorder_v7/drawings/shoe/11_整體爆炸組裝圖.png

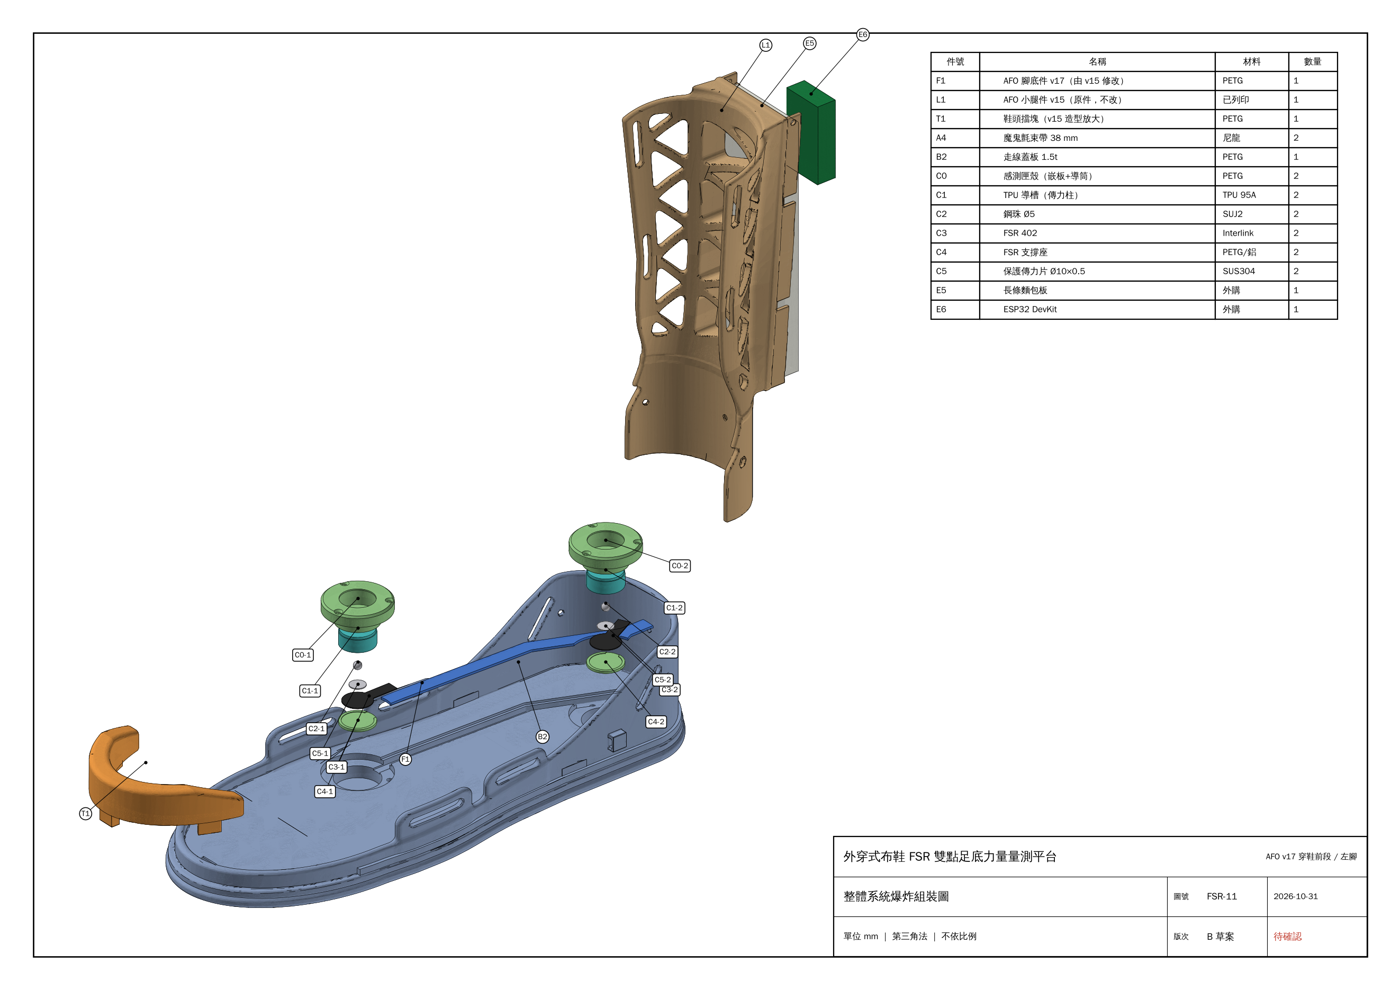
drawings/shoe/11_整體爆炸組裝圖.png
