jojo082708/fsr_recorder_v7/drawings/shoe/13_腳印鞋型重合俯視圖.png

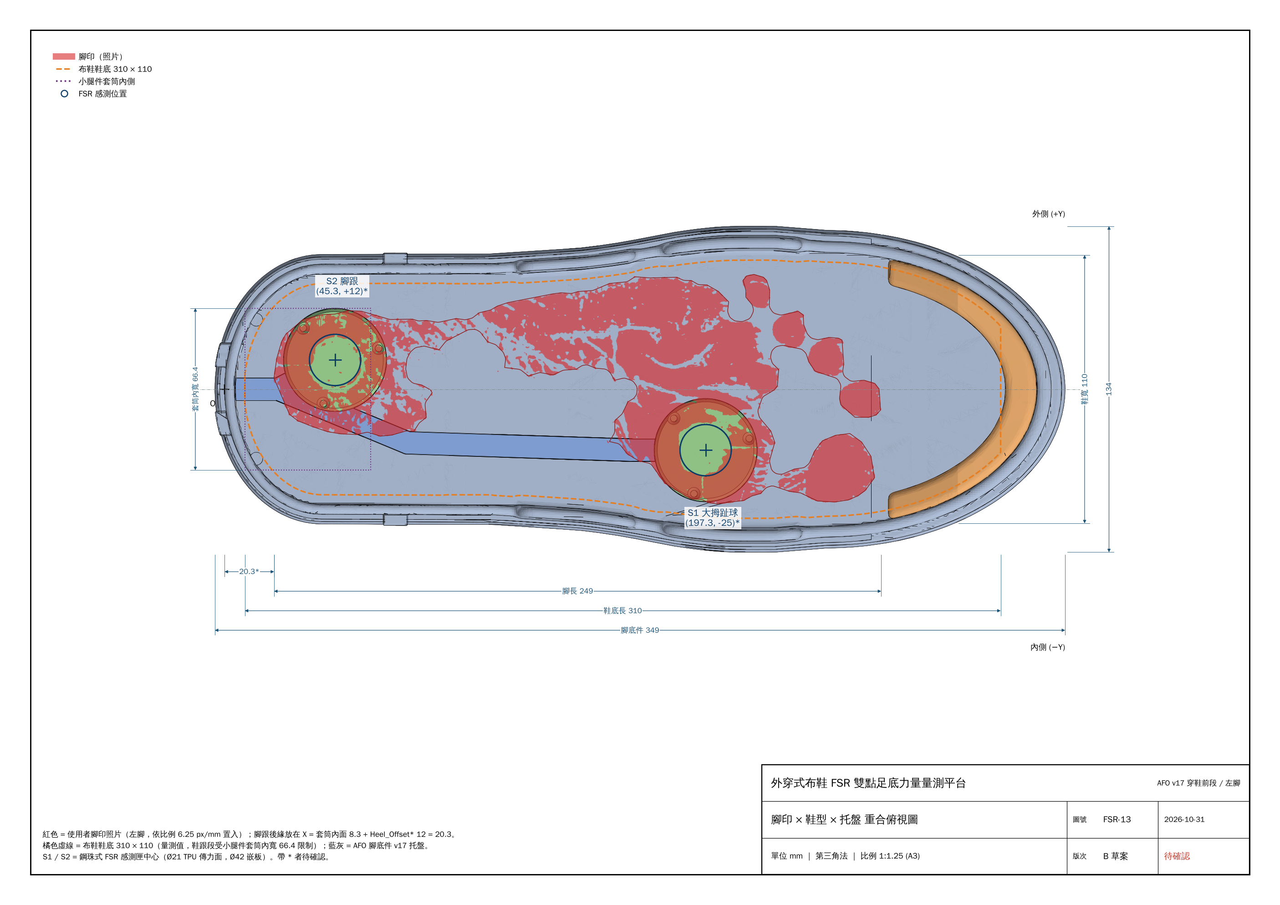
drawings/shoe/13_腳印鞋型重合俯視圖.png
