jojo082708/fsr_recorder_v7/drawings/textcad/overlay_top.png

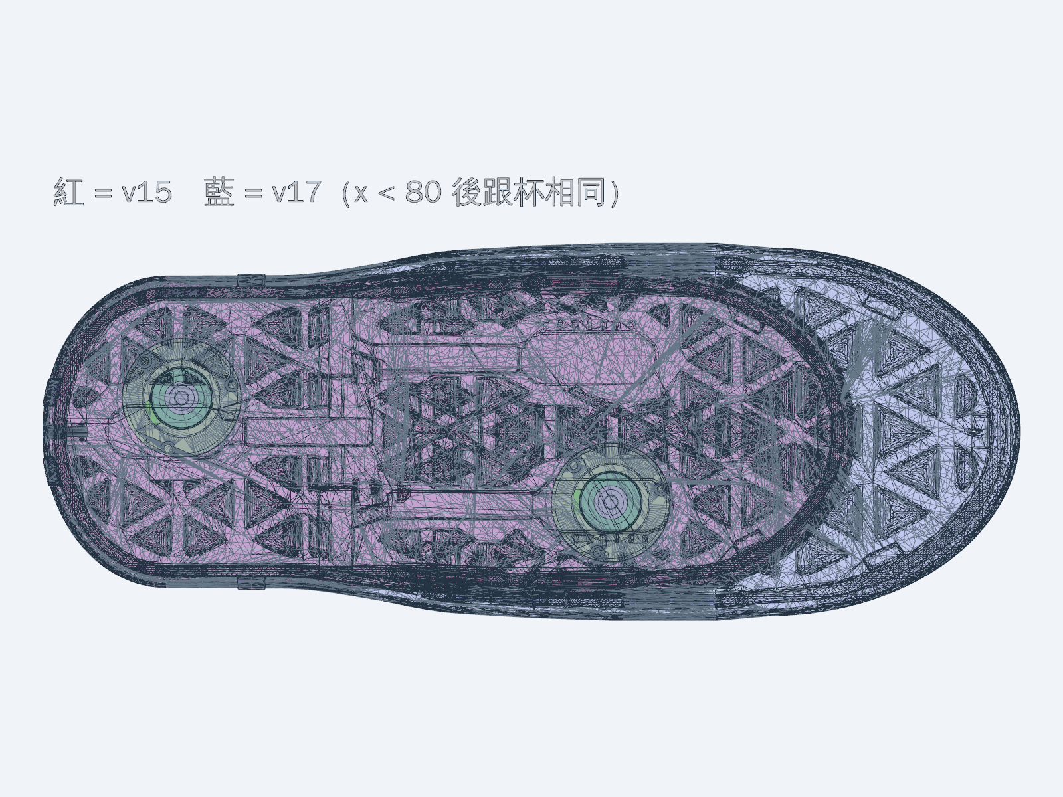
drawings/textcad/overlay_top.png
