jojo082708/fsr_recorder_v7/drawings/textcad/v15_vs_v17_top.png

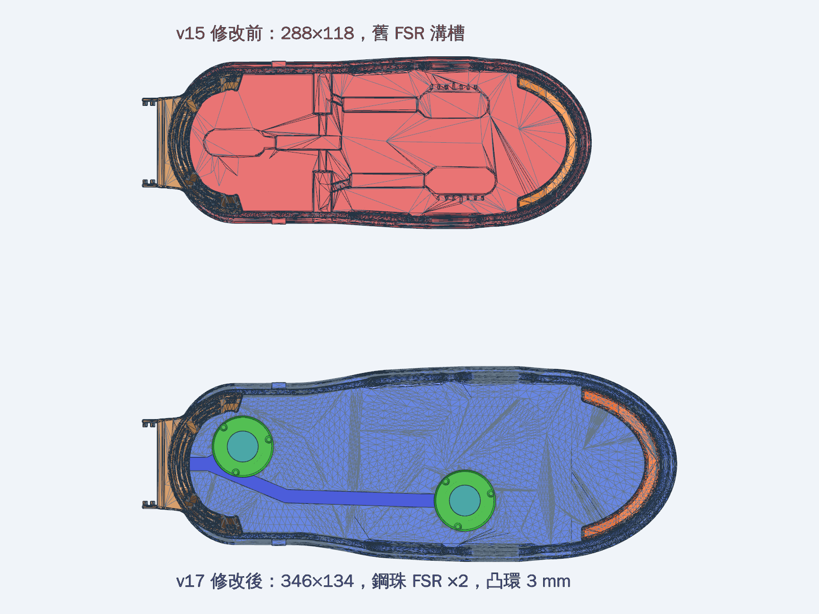
drawings/textcad/v15_vs_v17_top.png
