jojo082708/fsr_recorder_v7/cad/data/v15/AFO_leg.stl

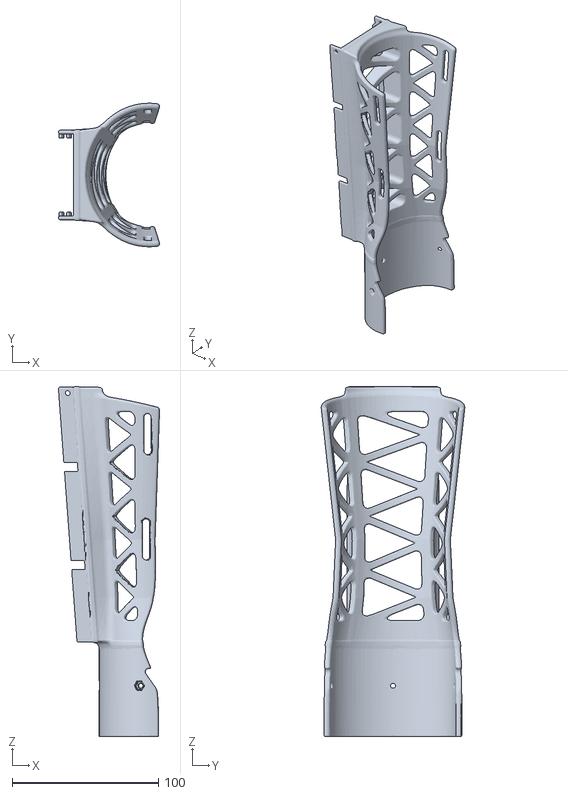
[picture p38: CAD file, 2026-10-31]
cad/data/v15/AFO_leg.stl
69.1 x 98.2 x 239.2
