jojo082708/fsr_recorder_v7/cad/data/v15/toe_stopper_H16_T6.stl

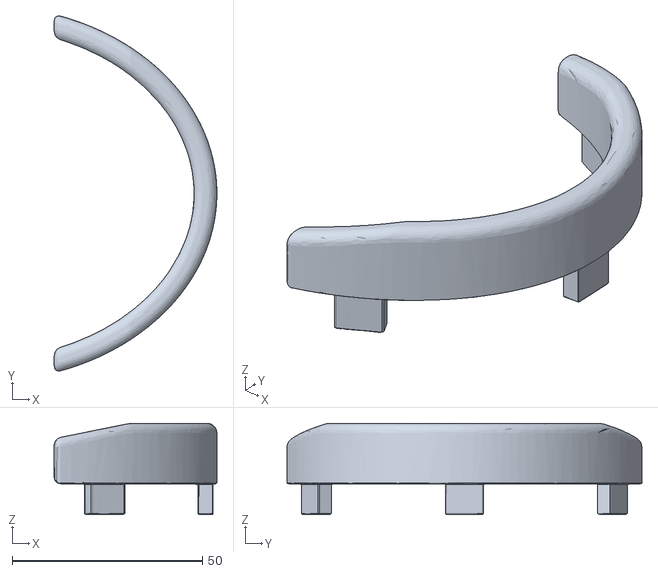
[picture p42: CAD file, 2026-10-31]
cad/data/v15/toe_stopper_H16_T6.stl
42.8 x 93.3 x 24.0
