jojo082708/fsr_recorder_v7/cad/data/v15/AFO_foot.stl

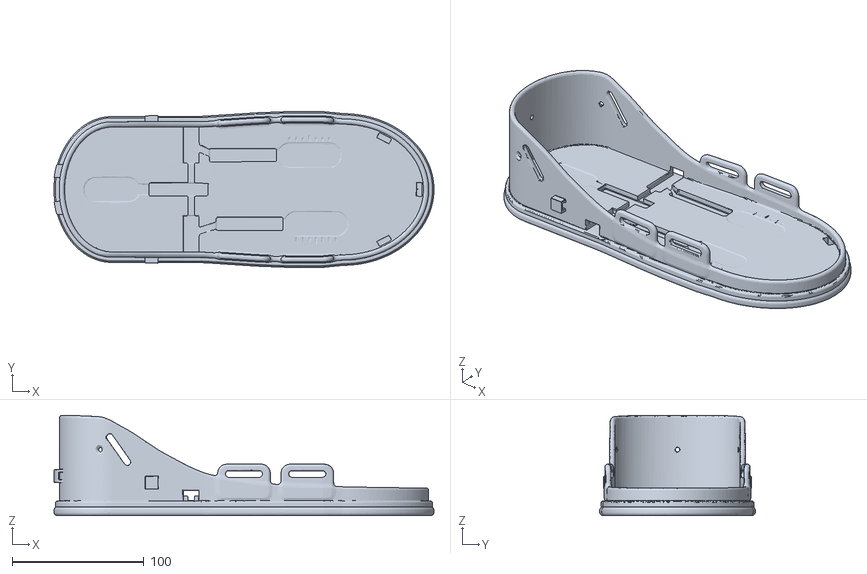
[picture p43: CAD file, 2026-10-31]
cad/data/v15/AFO_foot.stl
288.0 x 118.0 x 76.0
