jojo082708/fsr_recorder_v7/cad/data/v15/toe_stopper_H22_T9.stl

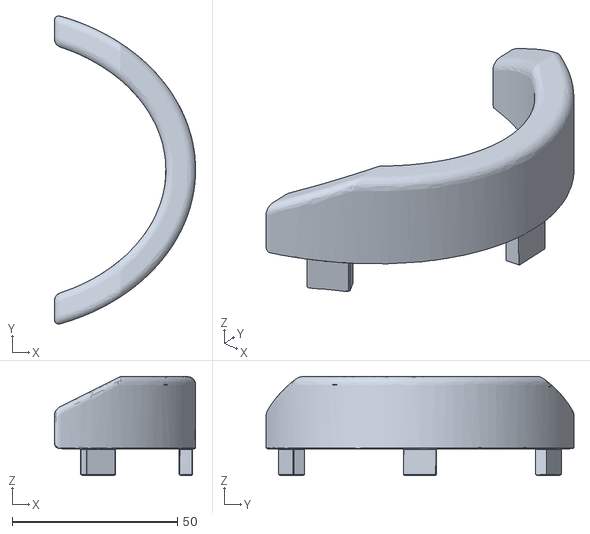
[picture p44: CAD file, 2026-10-31]
cad/data/v15/toe_stopper_H22_T9.stl
42.8 x 93.3 x 30.0
