jojo082708/fsr_recorder_v7/(commit log)

2026-10-31 Add dual-FSR shoe platform design (AFO v16 draft)
    Parametric CadQuery model, 12 engineering drawing sheets, and design
    document (parameter table with items to confirm, BOM, assembly,
    calibration, 3D-print notes). Foot plate outline digitized from the
    user's footprint; steel-ball FSR modules at 1st MTH and heel.
    Claude-Session: https://claude.ai/code/session_012w1y5Wzof72Ag8DWbi1BXv
    [footprint_outline_mm.csv]
2026-10-31 AFO v17: keep v15 leg and AFO tray shape, add dual ball-FSR pockets
    - Foot part is now the v15 AFO tray modified via mesh booleans:
    old FSR channels/slots filled, two flush ball-FSR cartridge pockets
    (1st MTH, heel), covered wire channel to heel-cup rear exit.
    - v15 leg (already printed, holds the breadboard) and toe stoppers
    are reused unchanged.
    - Removed the v16 foot-shaped platform and external electronics box.
    - New mesh-based drawing pipeline; 12 sheets regenerated; docs updated.
    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
    [AFO_foot.stl, AFO_leg.stl, toe_stopper_H16_T12.stl, toe_stopper_H16_T6.stl, toe_stopper_H16_T9.stl, toe_stopper_H22_T12.stl, toe_stopper_H22_T6.stl, toe_stopper_H22_T9.stl]
2026-10-31 AFO v17: size tray to measured shoe (310 x 110), add 3D viewer
    - Tray stretched forward of x=80 (x1.286 long, x1.133 wide, smooth
    blend); heel cup / v15 leg interface untouched; toe stopper warped
    with it.
    - export_glb.py + viewer page source; drawings and docs updated.
    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
    [afo_v17.py]
2026-10-31 Add footprint x shoe x tray overlay top view (FSR-13)
    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
2026-10-31 Add adjustable XY sensor mount concept (dovetail slider + pin mortise, scales) FSR-14/15
    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
2026-10-31 Fixed sensor positions with raised 3 mm ring; exports + text-to-cad model
    - Cartridge ring raised 3 mm above the tray floor (1.2 chamfer), fixed
    at the footprint positions; eccentric / sliding adjustment removed.
    - Export now writes STL, 3MF and STEP per part plus assembly STEP.
    - textcad/afo_v17.py: cadgen (text-to-cad) assembly reading the STEP parts.
    - Drawings, viewer and docs regenerated; adjustable-mount concept removed.
    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
    [afo_v17.py]
2026-11-01 Split foot into two printable parts (300x300x350 printer); v15 vs v17 compare
    - afo_v17.split_foot: x=120 floor lap joint (30 mm), 0.15 gap,
    6x M4 flat-head screws from below into rear-part heat-set inserts;
    lap zone made solid. Export now writes F1A rear / F1B front.
    - FSR-15 split drawing; FSR-14 before/after comparison sheet.
    - textcad/compare_v15_v17.py (cadgen side-by-side + overlay models)
    and cadgen snapshots; textcad/afo_v17.py uses split parts.
    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
2026-11-01 Add barefoot variant alongside shoe variant
    - AFO_VARIANT=shoe|barefoot in afo_v17.py; barefoot: foot 254x100,
    heel offset 0, one-piece 285 mm tray, no toe stopper (slots filled).
    - Drawings per variant (drawings/shoe, drawings/barefoot) + FSR-16
    two-version comparison; viewer switches between versions.
    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
2026-11-01 Barefoot variant: custom toe stopper following toe envelope
    Inner edge = toe envelope + 3 mm, 12 mm shell, 22 mm high, clipped to
    the tray wall; 2x 6 mm pegs into new floor holes (old v15 slots filled).
    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
2026-11-07 Modular kit: common rear + swappable fronts (shoe / barefoot / any size)
    - Warp now starts at x=140 (after the x=120 lap joint), so the rear
    part is identical for every size; fronts swap via the 6x M4 joint.
    - Barefoot uses a removable 12 mm heel spacer (H1) so the heel sits
    where it does in a shoe; S1/S2 are the same for both modes.
    - export_kit.py writes common rear + one folder per front size;
    FSR-17 modular sheet; drawings, viewer and docs regenerated.
    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
    [afo_v17.py, export_kit.py, make_modular_sheet.py, make_variants_sheet.py, overlay.py]
2026-11-13 High-precision export: 5 deg / 0.02 mm arc tolerance; re-drill v15 M3 holes as true circles
    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
    [afo_v17.py]
2026-11-13 Native build123d tray (smooth B-rep) for common rear + swappable fronts
    - textcad/tray/extract_v15_profiles.py: measure v15 outlines (plan, side,
    back, pockets) into v15_profiles.json
    - textcad/tray/tray_b3d.py: rebuild tray natively in build123d (corner-
    preserving spline fit, true-circle holes), apply v17 mods from
    afo_v17.native_spec(), split rear/front; stl_patch.py closes tiny
    tessellation gaps
    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
    [afo_v17.py]
